wyatt-liao/yuhuan-x1/hardware/README.md

# 硬件

当前原生工程：[语环X1-独立麦克风与双按键.epro2](语环X1-独立麦克风与双按键.epro2)。使用嘉立创 EDA 专业版 / EasyEDA Pro 导入。

| 内容 | 入口 |
|---|---|
| 独立四麦与双按键改线 | [改线说明](reviews/语环X1-本次改线说明.md) |
| 改线后的 PCB 图 | [PCB 预览](reviews/语环X1-改线后PCB.png) |
| 初始板子的投产前审查 | [历史审查](reviews/PCB1-投产前审查.md) |
| 检查与改线证据压缩包 | [下载索引](../outputs/README.md#硬件与证据) |
| 对应固件与引脚 | [固件 README](../firmware/README.md) |
| 结构与电池槽 | [外壳 README](../enclosure/README.md) |

主控为 ESP32-S3-WROOM-1-N16R8。当前方案将四只麦克风的时钟、数据分开引出，双按键分别用于手动录音和暂停 / 回溯保存；具体 GPIO 以固件表格和原生工程为准。

电池方案为带保护板的 504060、3.7 V、2000 mAh，置于 PCB 槽内。外壳建模按电池引线直焊、移除直立 BAT1 XH 插座考虑，电池成品外形尚未实测；投板与装配前应核对原生工程和实际 BOM。

这里保留的是设计、修改和检查记录，尚无实板上电、录音或长时间验证结果。历史审查结论对应其记录时的板子状态，后续改线见对应说明。
