wyatt-liao/yuhuan-x1/media/README.md

# 产品影片与汇报

当前视频与汇报统一使用语环 X1 名称和 R03 CAD 结构：主体厚度 9.80 mm，含按键最高 10.15 mm，保留铝塑分区、外露圆头榫接和实际开孔。

- [R03 影片工程与播放说明](film/README.md)
- [当前 Blender 场景](film/assets/Yuhuan-X1-R03-CG.blend)
- [HTML 汇报与构建源码](report/README.md)
- [影片、汇报及源码包下载](../outputs/README.md)

手机画面来自当前 Android Demo；AI 整理与提醒仍为后续开发计划。结构、续航及硬件实物验证状态见[项目进度](../docs/PROJECT_STATUS.md)。旧概念片保留在历史下载中。
