wyatt-liao/yuhuan-x1/outputs/yuhuan-x1-report/使用说明.md

# 语环 X1 汇报使用说明

这套汇报共 14 页，建议讲述约 8 分钟。最后一页为参数附录。

## 放映

1. 用 Chrome、Edge 或 Safari 打开 `语环X1-产品研发汇报.html`。
2. 按 F 全屏，使用左右方向键或空格翻页。
3. 按 O 打开目录，按 N 查看当前页讲稿和资料来源，按 B 临时黑屏。

所有图片均内嵌，HTML 单独拷贝到其他电脑也可以离线放映。手机支持左右滑动；正式汇报推荐横屏或电脑投屏。HTML 需要在浏览器打开，聊天软件的文件预览可能不会执行交互脚本。

第 4 页可点击按钮，演示保存最近 1、3、6、24 小时的范围。这是机制演示，不连接实际录音卡。

讲稿弹窗会显示在当前屏幕，正式投屏前请关闭。可以把 `汇报讲稿.md` 放在手机上查看。PDF 备用版不含交互，适合发送资料或临时换电脑。

## 内容基准

当前视频、封面和汇报统一采用 R03 CAD 结构。主体厚度 9.80 mm，含按键最高 10.15 mm。24 小时是循环录音保留窗口；续航待实测。手机 AI 识别和提醒属于后续规划。

如需改文字，可直接编辑 HTML，或修改仓库 `media/report/` 下的构建源码。
