wyatt-liao/yuhuan-x1/hardware/reviews/语环X1-本次改线说明.md

# 语环 X1 本次改线说明

日期：2026-10-18。状态：原理图与 PCB 已现场修改，完成显式保存、关闭重载、逐脚回读、铜线连通检查及两轮原生 DRC。尚无实物上电测试。

已修改嘉立创窗口中 `MeetCard-AI-repair-loop-20261018 / Board1 / PCB1`。原生工程副本为 `语环X1-独立麦克风与双按键.epro2`。PCB 未制造，当前修改发生在工程内，无需实板飞线。

## 修改内容

第二按键 SW2.1 从 EN 改到 BTN2 / GPIO15 / U1.8；SW2.2 保持 GND，原有 EN 上拉、复位电容和 U1.3 的连接保留。SW1 保持 GPIO0。

四只麦克风保持共用 3V3 供电，每只拥有独立 CLOCK 和 DATA；没有增加负载开关、MOS 管或其他元件。

| 麦克风 | CLOCK | DATA | SELECT |
|---|---|---|---|
| MIC1 | GPIO4 / U1.4 / I2S_SCK | GPIO6 / U1.6 / I2S_DIN12 | GND |
| MIC2 | GPIO16 / U1.9 / CK2 | GPIO5 / U1.5 / D2 | 3V3 |
| MIC3 | GPIO17 / U1.10 / CK3 | GPIO7 / U1.7 / I2S_DIN34 | GND |
| MIC4 | GPIO18 / U1.11 / CK4 | GPIO8 / U1.12 / D4 | 3V3 |

旧网名 I2S_DIN12、I2S_DIN34 保留用于 MIC1、MIC3，名字不再代表两个麦克风共享。数据分别引出，避免停钟/启动时共享 DATA 的占用问题。GPIO5 原来的 I2S_WS 标签已移除；PDM 接口不用独立 WS。

## 钢网兼容范围

51 个器件的身份、坐标、朝向、所在面均未变；227 个焊盘实例的坐标和形状均未变；板框、丝印、禁布区和板内开槽/填充不变。两份原生工程内的 22 个 FOOTPRINT 文档体 SHA-256 完全相同，因此封装内焊膏开口、声孔及焊盘定义未变。这次改线本身不要求重做钢网。

没有取得你实际下单的钢网 Gerber/拼板定位文件，因此这里证明的是“相对改前工程保持兼容”。沿用下单时的拼板排列、工艺边和定位方式。

原生工程导出差异另含 Panel1 新增的 CANVAS 画布元数据（material=acrylic、thickness=0.8mm 等默认画布字段）；未调用面板编辑接口，此记录不是 PCB 叠层参数，也没有用作本次钢网或制板依据。P2/P4、全部库封装和其余设计文档体保持原样。实际制造请从 PCB1 导出并检查 Gerber，不要把 Panel1 当作钢网文件。

## 连接与规则复核

51 个器件、227 个焊盘实例与原理图逐脚网络对账一致。移除了归属明确的 41 段旧铜线、8 个过孔，新增 44 段线、10 个过孔；其他既有铜线保持。

保存重载后两轮原生 PCB DRC 均为 passed=true，total=0。下列新增网络用实际铜线逐一证明焊盘可达，包含真实换层和过孔，不以同名网代替物理连通。

| 网络 | 端点 | 实际中心线路径 | 过孔 |
|---|---|---:|---:|
| BTN2 | SW2.1 → U1.8 | 32.49mm | 2 |
| CK2 | U1.9 → MIC2.3 | 52.43mm | 2 |
| CK3 | U1.10 → MIC3.3 | 108.92mm | 0 |
| CK4 | U1.11 → MIC4.3 | 98.01mm | 2 |
| D2 | U1.5 → MIC2.1 | 52.95mm | 2 |
| D4 | U1.12 → MIC4.1 | 96.77mm | 2 |

路径不计过孔垂直长度，不是信号完整性仿真。新信号宽 6mil，沿原有电池/天线禁布区绕行。原理图保留基线已有的 BAT_ADC/GND 标签视觉重叠、C3 位号遮挡等图面警告；没有据此将电气连接判作通过或失败。

## 同步、校准与省电

采用同一个 I2S0 PDM RX 硬件时钟经 GPIO Matrix 分发，四只麦克风不是四套自由运行时钟。数据四路同时进入同一接收器。平时只让 MIC1 CLOCK 工作，其他 CLOCK 拉低；人声触发后连接同一时钟，MIC1 继续录制，固件约300ms后才使用新麦克风数据。

IM69D130 原厂资料的 Clock Off Mode 要求 CLOCK 拉低；表5给出启动/模式切换稳定时间：±0.5dB约20ms、±0.2dB约50ms。300ms是本 Demo 加上滤波/DMA余量的设计取值，仍需样机验证。原厂资料副本及读取文本存于证据包，来自库器件关联的 LCSC 数据手册页。

这种接法允许同步采集，分开走线本身不构成必须使用四套校准时钟的理由。但仍须实测：声道顺序、四路增益、固定相对延迟、反复停钟唤醒后的延迟是否一致，以及外壳声孔对声学响应的影响。PCB DRC 不验证这些事项。

当前固件做四麦声道选择，保存16kHz单声道 ADPCM WAV；没有声称已完成立体声输出、阵列校准、波束成形或 AI 降噪。手机 App 和 AI 提醒尚未实现，已交付本地 BLE/Wi-Fi 协议与手机后端模拟器。

2000mAh 电池续航仍需电池侧电流实测。停掉三只麦克风只降低相应麦克风/时钟负载，主控、SD、无线仍耗电，不能按四倍续航计算。

## 交付与未覆盖项

证据包含改线意图、原理图前后、PCB前后、删除/创建日志、保存与重载回执、两轮 DRC、六网路径、封装开口比对和最终工程导出记录。原始投产前审查保留为历史基线，电源/USB 的既有布局问题没有在本次麦克风和按键改线中处理。

可进入工程样机制作及功能调试。本次结果不构成量产放行；目前没有上电录音、USB枚举、SD压力、充放电和长期续航数据。烧录和手机同步的步骤见固件工程 README。
