wyatt-liao/yuhuan-x1/android/licenses/AndroidX-icons-NOTICE.md

# AndroidX Material icons

Selected outlined icon source files are copied without modification from Google AndroidX `material-icons-extended-android:1.7.8`, licensed under Apache-2.0. Original copyright headers remain in every file. The full extended binary library is not included.

Official Maven source artifact: `androidx/compose/material/material-icons-extended-android/1.7.8/material-icons-extended-android-1.7.8-sources.jar`

Source archive SHA-256: `77b7e782a519a3e074fc91e09d59334ac1b815edd87d2e89c0c9ca7c95678e93`

Vendored icons: AutoAwesome, BatteryStd, Bluetooth, BluetoothDisabled, BluetoothSearching, BookmarkBorder, BookmarkRemove, CalendarToday, ChevronRight, DeleteOutline, Download, EditNote, FiberManualRecord, Forward30, GraphicEq, History, LinkOff, MicNone, Pause, PhoneAndroid, PlayCircle, Replay10, SdCard, Sensors, Shield, Stop, Sync, Wifi

Other icons come from `material-icons-core`.

AutoMirrored outlined BluetoothSearching is also included from the same source archive.
