wyatt-liao/yuhuan-x1/outputs/yuhuan-x1-report/汇报讲稿.md

# 语环 X1 产品研发汇报讲稿

日期：2026-10-19。建议主体约 8 分钟，第 14 页为答疑参数。

## 01 语环 X1

大家好，今天汇报的是语环 X1，一款可以回溯保存的随身录音卡。我们希望解决一个很具体的问题：当用户意识到一句话很重要时，这句话往往已经说完了。语环先在设备上保留最近的录音，用户再通过一个简单的按键动作，把重要内容留下。当前硬件、固件、安卓端与结构文件已经形成配套工程，下一步进入实物验证。

资料：[项目总览](https://github.com/wyatt-liao/yuhuan-x1/blob/c01c0e15f273b57459ff1d528d4bf85e318d61fd/README.md)、[影片模型与结构的统一说明](https://github.com/wyatt-liao/yuhuan-x1/blob/main/media/film/README.md)

## 02 值得记录的时刻，常常先于录音动作

这页描述的是我们准备验证的使用场景，不是已经完成的市场调查。一个问题是录音启动晚于重要内容，另一个问题是录下之后很难再找。传统手动录音要求用户提前判断什么值得记录，而我们的设计把保存的决定放到事情发生之后。第一阶段先验证回溯保存是否真的方便，后续再用语音识别和信息整理降低重听成本。

## 03 设备负责记录，手机负责接收与整理

整体分工是，录音卡负责连续采集和本地保存，手机负责接收、播放和后续整理。当前 Demo 不建设云端服务，先利用手机作为本地后端。这样可以把设备采集、回溯保存和手机接收先联通，再接入真正的识别与 AI。这里展示的是 R03 的结构渲染，还不是已经完成实物装配的产品照片。

资料：[固件行为](https://github.com/wyatt-liao/yuhuan-x1/blob/c01c0e15f273b57459ff1d528d4bf85e318d61fd/firmware/README.md)、[Android 功能](https://github.com/wyatt-liao/yuhuan-x1/blob/c01c0e15f273b57459ff1d528d4bf85e318d61fd/android/README.md)

## 04 按一下，留下前一小时

这一页可以现场点击演示。默认单击一次，最后一小时会被标记保护。换成连续三次，就保护前三小时。设备不需要现场复制几小时的文件，而是保存持久化保护标记，避免这些内容被循环清理。回溯最多二十四小时，设备没录满时只能保留已有内容。需要特别区分：二十四小时描述的是录音保留窗口，电池续航还没有实测结果。

资料：[回溯保护与存储边界](https://github.com/wyatt-liao/yuhuan-x1/blob/c01c0e15f273b57459ff1d528d4bf85e318d61fd/firmware/README.md)、[按键与存储核心](https://github.com/wyatt-liao/yuhuan-x1/blob/c01c0e15f273b57459ff1d528d4bf85e318d61fd/firmware/components/yh_core/include/yh/buttons.hpp)

## 05 两个实体按键

实体交互保留两个按键。第一个按键负责一段手动录音的开始和结束。第二个按键在手动录音过程中用于暂停和继续，在没有手动录音时用于回溯保存。暂停时，后台环形录音仍然继续，所以不会因为用户暂停了一个手动任务，就失去整个回溯窗口。连续点击由固件统一判断，停止点击五百毫秒之后执行。

资料：[按键状态表](https://github.com/wyatt-liao/yuhuan-x1/blob/c01c0e15f273b57459ff1d528d4bf85e318d61fd/firmware/README.md)

## 06 硬件与手机的系统分工

硬件采用 ESP32-S3，四只麦克风独立引出时钟和数据，录音按一分钟分片存到 SD 卡。当前保存格式是十六千赫兹单声道 IMA ADPCM WAV，二十四小时音频大约七百零一兆字节。BLE 主要负责配对、控制和网络配置，大批量历史内容优先走同一局域网内的 Wi-Fi。手机在文件完整校验并落盘后才确认成功，真实吞吐和兼容性还需要实板联调。

资料：[硬件工程说明](https://github.com/wyatt-liao/yuhuan-x1/blob/c01c0e15f273b57459ff1d528d4bf85e318d61fd/hardware/README.md)、[设备同步协议](https://github.com/wyatt-liao/yuhuan-x1/blob/c01c0e15f273b57459ff1d528d4bf85e318d61fd/firmware/PROTOCOL.md)

## 07 按人声切换麦克风工作模式

功耗设计的重点是让采集资源随需求变化。平时只有第一只麦克风获得工作时钟，同时检测人声。确认有人声后，打开其他三路时钟，并留出稳定时间。当前算法进行声道选择和交叉淡化，输出仍然是单声道，没有把它包装成已实现的波束成形。四麦供电仍然共用，ESP32、SD 卡和无线也在耗电，因此不能用一麦来推算整机只消耗四分之一电量。

资料：[麦克风与功耗策略](https://github.com/wyatt-liao/yuhuan-x1/blob/c01c0e15f273b57459ff1d528d4bf85e318d61fd/firmware/README.md)、[采集实现](https://github.com/wyatt-liao/yuhuan-x1/blob/c01c0e15f273b57459ff1d528d4bf85e318d61fd/firmware/main/audio.cpp)

## 08 薄型结构的首件方案

轻薄是产品方向，影片、汇报和制造文件现在统一采用 R03 结构。首件为了适应树脂打印，主面与侧壁调整到两毫米，主体总厚度九点八毫米。电池放在 PCB 槽中，而不是叠在电路板上，连接改为引线直焊。结构保留外露圆头榫接以及未来铝塑分区，先完成样壳装配，再讨论 CNC 方案和进一步减薄。

资料：[R03 打印与装配](https://github.com/wyatt-liao/yuhuan-x1/blob/c01c0e15f273b57459ff1d528d4bf85e318d61fd/enclosure/r03/README-%E6%89%93%E5%8D%B0%E4%B8%8E%E6%8B%BC%E7%89%88%E8%AF%B4%E6%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)、[版本状态](https://github.com/wyatt-liao/yuhuan-x1/blob/c01c0e15f273b57459ff1d528d4bf85e318d61fd/docs/PROJECT_STATUS.md)

## 09 Android Demo 已形成可安装工程

安卓端已经形成可安装的原生 Demo，使用 Kotlin 和 Jetpack Compose。现在已经有设备连接、录音控制、文件接收、本地播放、备注和分享，也实现了断点续传与下载校验。画面是模拟器真实截图，里面的短音频来自测试 APK。当前软件不伪造转写或摘要，AI 页面会明确显示尚未分析。真实板子的配对、网络速度和后台稳定性还需要联调。

资料：[Android 实现与边界](https://github.com/wyatt-liao/yuhuan-x1/blob/c01c0e15f273b57459ff1d528d4bf85e318d61fd/android/README.md)、[Android 验证记录](https://github.com/wyatt-liao/yuhuan-x1/blob/c01c0e15f273b57459ff1d528d4bf85e318d61fd/android/release/verification.md)

## 10 下一阶段的 AI 生活助手

这是下一阶段的功能规划。设备把声音交给手机之后，我们希望手机先做转写，再从里面提取任务、时间和摘要。比如用户说周五下午三点发送方案，系统应识别出事项和候选时间，再让用户核对并确认提醒。它需要结合上下文处理日期和指代，所以不能只靠一个示例就宣称已经完成。目前 ASR、模型调用和提醒排程都还没有接入。

资料：[AI 当前状态](https://github.com/wyatt-liao/yuhuan-x1/blob/c01c0e15f273b57459ff1d528d4bf85e318d61fd/android/README.md)、[研发进度](https://github.com/wyatt-liao/yuhuan-x1/blob/c01c0e15f273b57459ff1d528d4bf85e318d61fd/docs/PROJECT_STATUS.md)

## 11 当前交付与验证进度

当前成果已经形成完整工程链：硬件有原生 PCB 和改线记录，固件有编译产物与主机测试，安卓有安装包、六项核心 JVM 测试和模拟器界面检查，结构有 STEP、STL 和几何报告。这里不使用一个笼统的完成百分比，而是把成果和下一项实物验证并排列出。最关键的缺口仍是第一块板子的上电和连续录音联调。

资料：[完整项目状态](https://github.com/wyatt-liao/yuhuan-x1/blob/c01c0e15f273b57459ff1d528d4bf85e318d61fd/docs/PROJECT_STATUS.md)、[Android 测试依据](https://github.com/wyatt-liao/yuhuan-x1/blob/c01c0e15f273b57459ff1d528d4bf85e318d61fd/android/release/verification.md)、[结构检查](https://github.com/wyatt-liao/yuhuan-x1/blob/c01c0e15f273b57459ff1d528d4bf85e318d61fd/enclosure/r03/verification/geometry-check.json)

## 12 下一步以样机验证推进

接下来的重点很明确。先把板子做出来，确认每一个麦克风与存储链路都工作，再验证连续录音和手机同步能同时运行。结构和电流需要真实测量，才能讨论进一步减薄和续航。完成这些之后，再接入手机侧 AI，并用真实录音检验转写与待办提取效果。阶段以验证结果推进，这里不虚构交付日期或预算。

资料：[实物验证清单](https://github.com/wyatt-liao/yuhuan-x1/blob/c01c0e15f273b57459ff1d528d4bf85e318d61fd/firmware/README.md)、[项目后续步骤](https://github.com/wyatt-liao/yuhuan-x1/blob/c01c0e15f273b57459ff1d528d4bf85e318d61fd/docs/PROJECT_STATUS.md)

## 13 重要的，回头还在

语环 X1 的核心是，把保存重要内容的决定，放到内容发生之后。当前已经完成配套工程与 Demo，近期的目标是让第一台样机完成连续录音、回溯保存和手机同步。项目资料已经公开，欢迎围绕硬件、结构和使用体验提出问题。谢谢。

资料：[公开仓库](https://github.com/wyatt-liao/yuhuan-x1/blob/c01c0e15f273b57459ff1d528d4bf85e318d61fd/README.md)

## 14 附录：参数与版本口径

这页用于答疑。涉及产品参数时以这里和工程 README 为准。影片和汇报现在统一使用九点八毫米主体的 R03 首件结构，最高处含按键为十点一五毫米。二十四小时是保留窗口，续航未实测。四路采集也不等于已经实现立体声、阵列算法或 AI。

资料：[固件参数](https://github.com/wyatt-liao/yuhuan-x1/blob/c01c0e15f273b57459ff1d528d4bf85e318d61fd/firmware/README.md)、[Android 参数](https://github.com/wyatt-liao/yuhuan-x1/blob/c01c0e15f273b57459ff1d528d4bf85e318d61fd/android/README.md)、[R03 参数](https://github.com/wyatt-liao/yuhuan-x1/blob/c01c0e15f273b57459ff1d528d4bf85e318d61fd/enclosure/r03/README-%E6%89%93%E5%8D%B0%E4%B8%8E%E6%8B%BC%E7%89%88%E8%AF%B4%E6%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)
