wyatt-liao/yuhuan-x1/android/design-reference/x1_3/screen.png

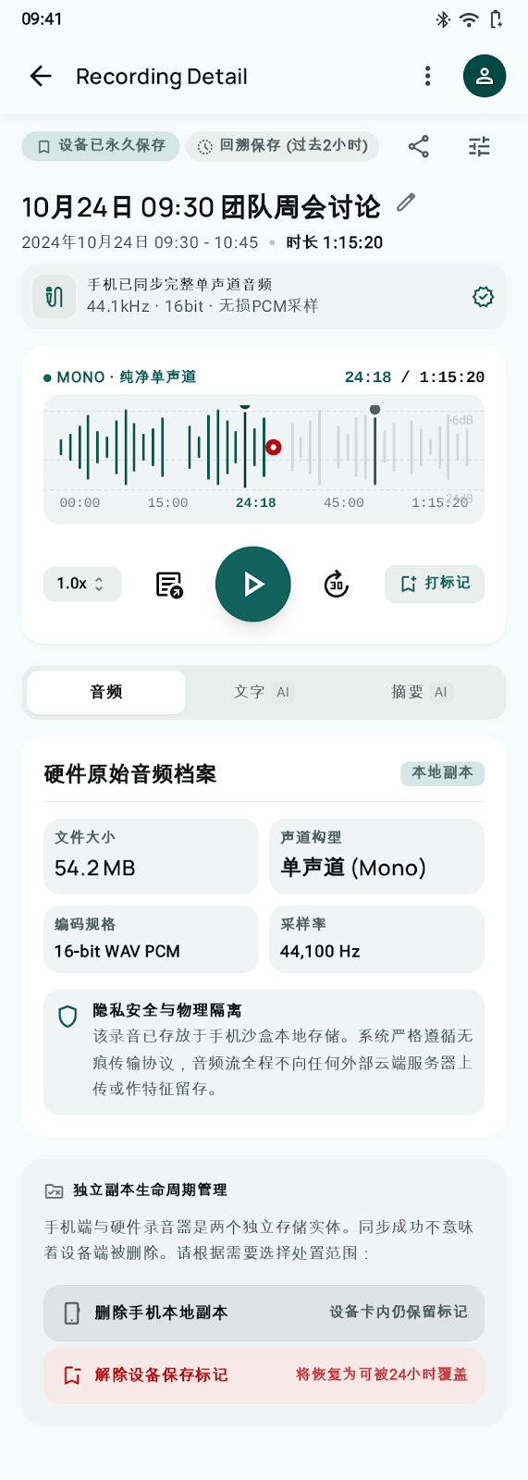
android/design-reference/x1_3/screen.png
