wyatt-liao/yuhuan-x1/android/design-reference/x1_4/screen.png

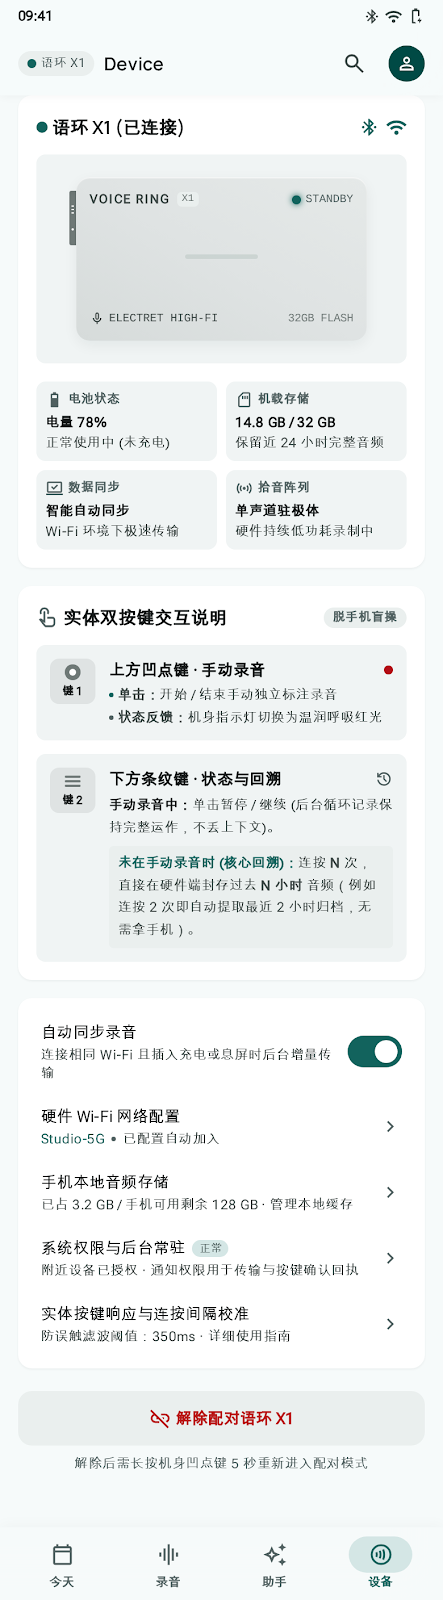
android/design-reference/x1_4/screen.png
