wyatt-liao/yuhuan-x1/android/release/preview.png

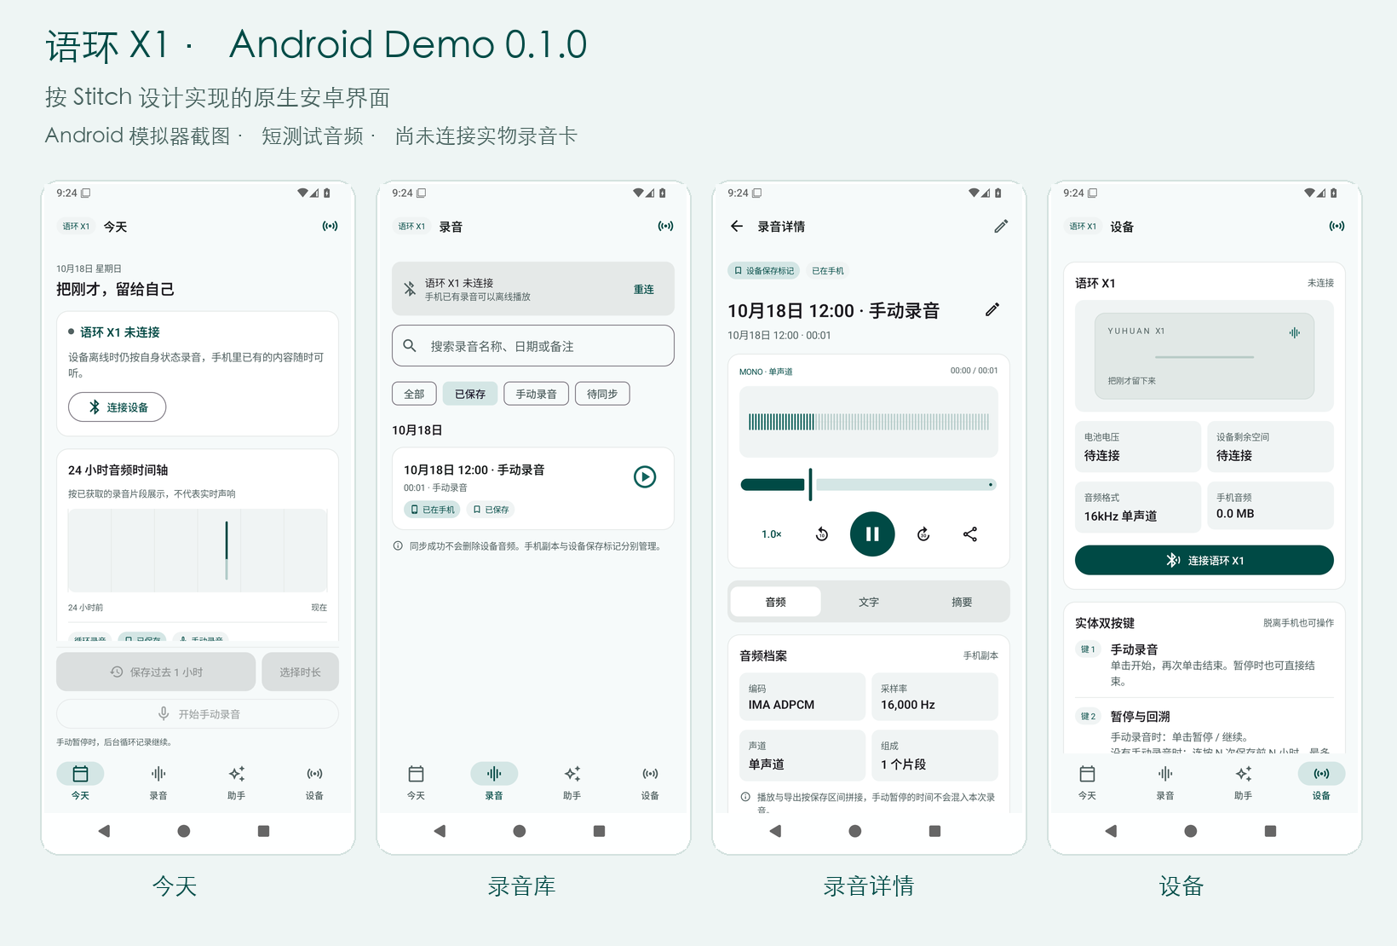
android/release/preview.png
