wyatt-liao/yuhuan-x1/android/release/screenshots/landscape/01-today.png

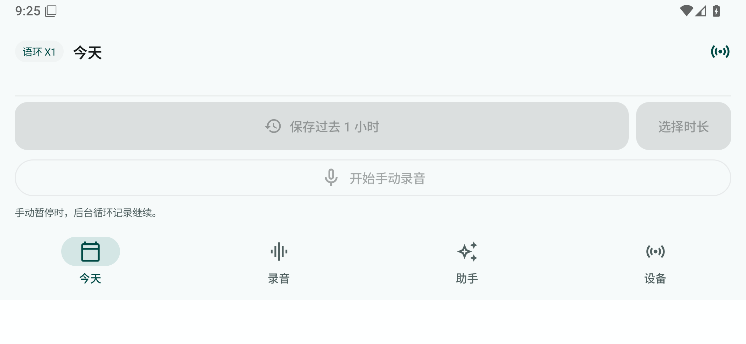
android/release/screenshots/landscape/01-today.png
