wyatt-liao/yuhuan-x1/android/release/screenshots/landscape/02-library.png

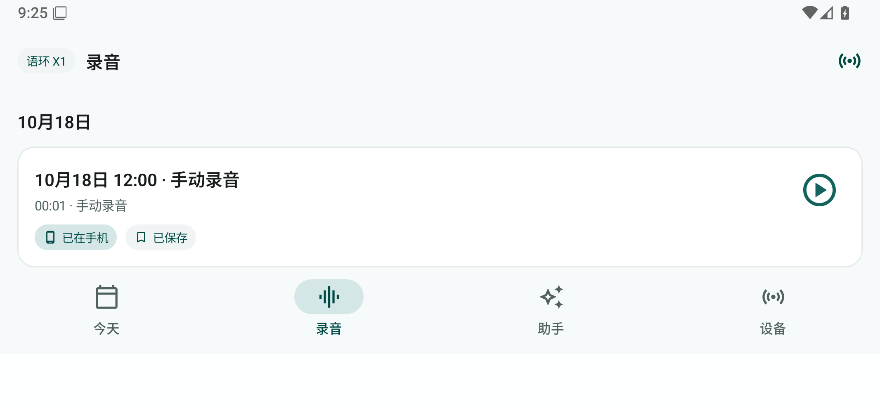
android/release/screenshots/landscape/02-library.png
