wyatt-liao/yuhuan-x1/android/release/screenshots/landscape/03-detail.png

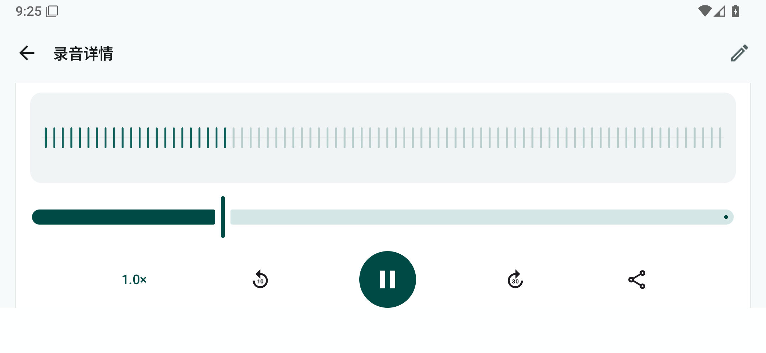
android/release/screenshots/landscape/03-detail.png
