wyatt-liao/yuhuan-x1/android/release/screenshots/landscape/04-assistant.png

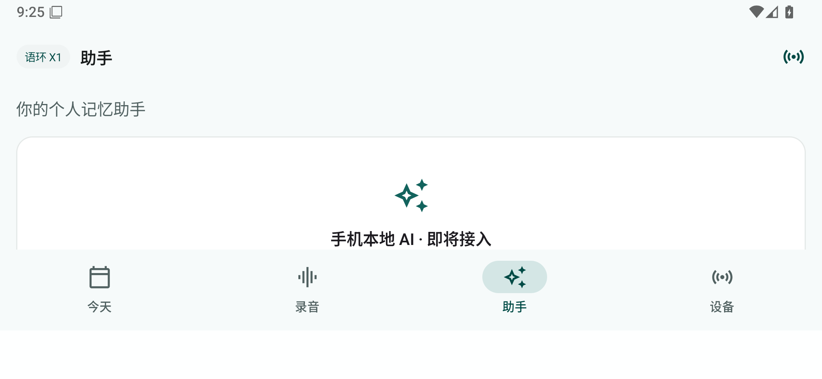
android/release/screenshots/landscape/04-assistant.png
