wyatt-liao/yuhuan-x1/android/release/screenshots/landscape/05-device.png

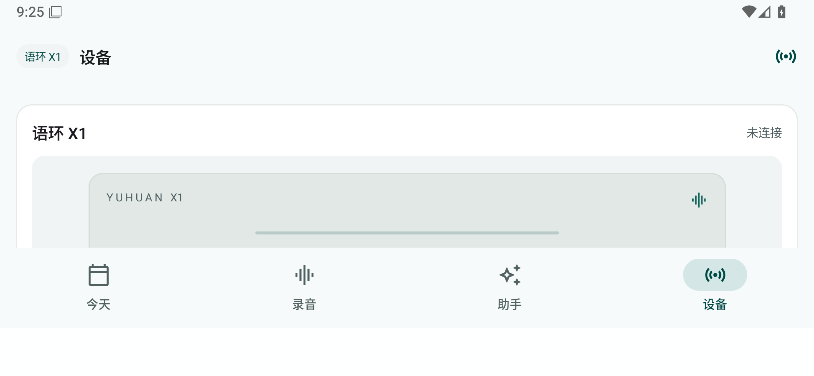
android/release/screenshots/landscape/05-device.png
