wyatt-liao/yuhuan-x1/android/release/screenshots/landscape/06-connect.png

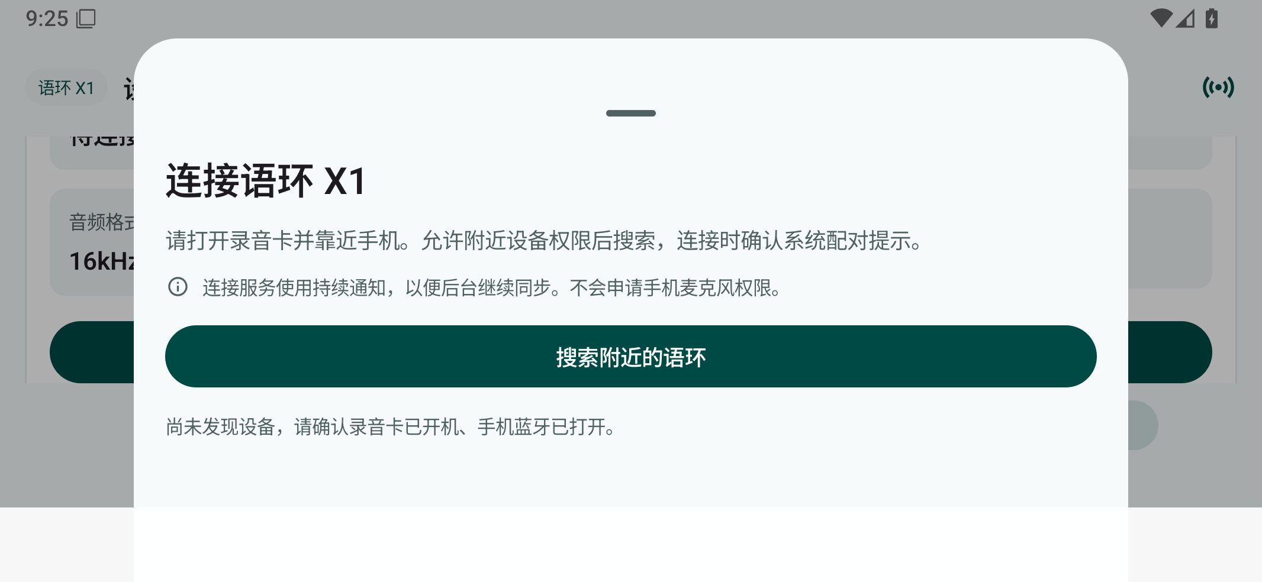
android/release/screenshots/landscape/06-connect.png
