wyatt-liao/yuhuan-x1/android/release/screenshots/normal/02-library.png

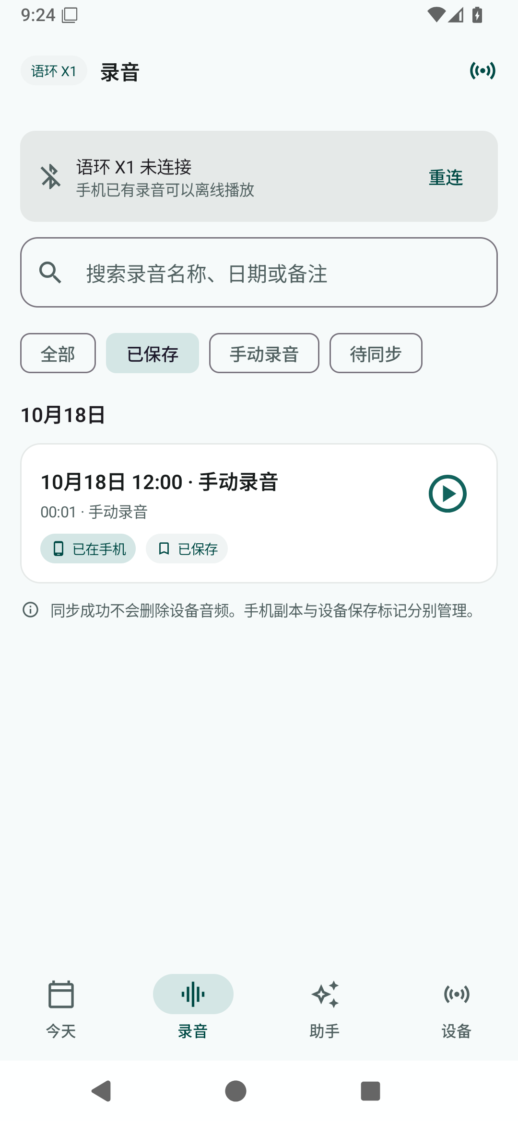
android/release/screenshots/normal/02-library.png
