wyatt-liao/yuhuan-x1/android/release/screenshots/normal/04-assistant.png

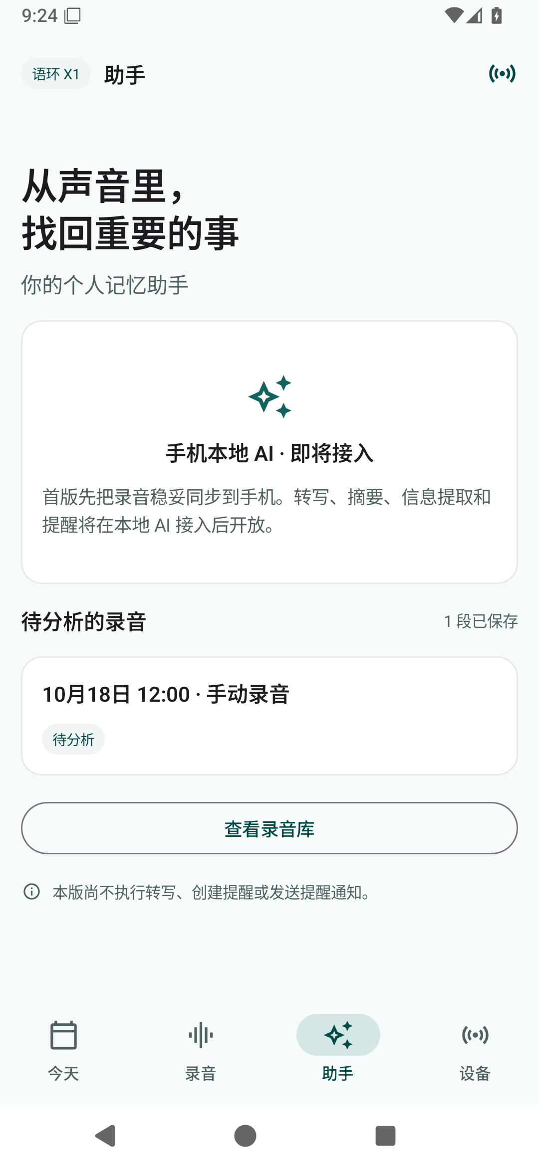
android/release/screenshots/normal/04-assistant.png
