wyatt-liao/yuhuan-x1/android/release/screenshots/normal/05-device.png

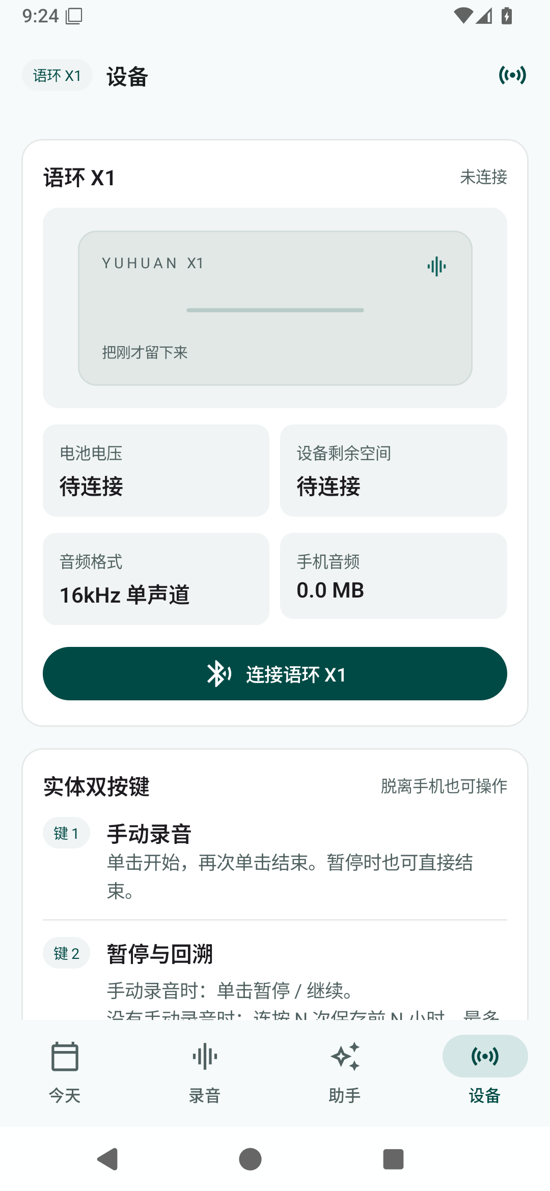
android/release/screenshots/normal/05-device.png
