wyatt-liao/yuhuan-x1/android/release/screenshots/normal/06-connect.png

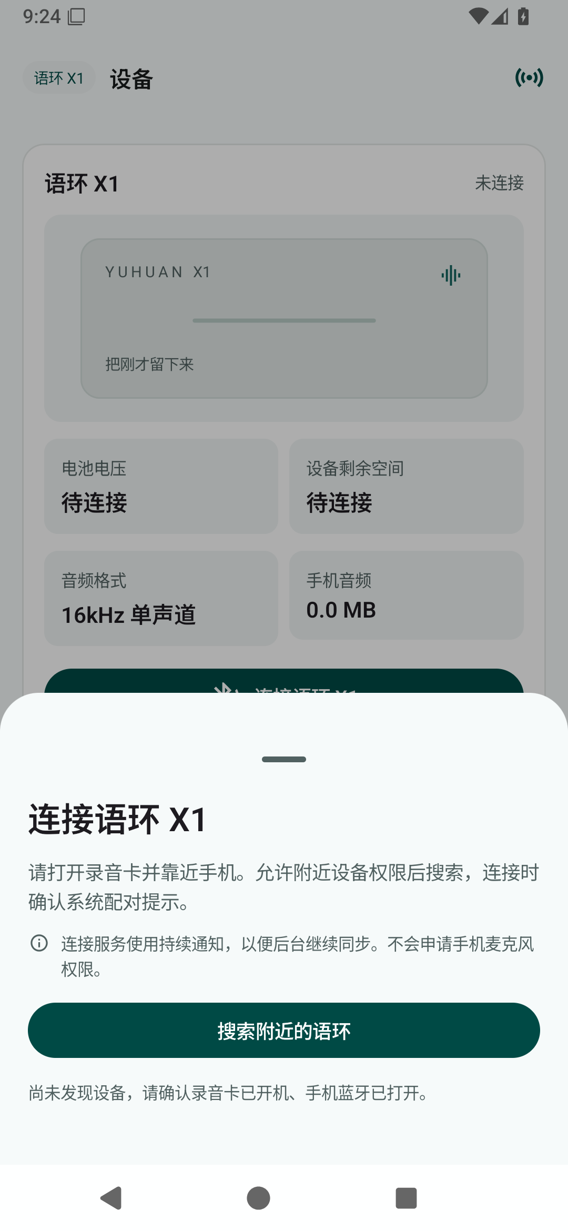
android/release/screenshots/normal/06-connect.png
