wyatt-liao/yuhuan-x1/android/release/screenshots/small-largefont/01-today.png

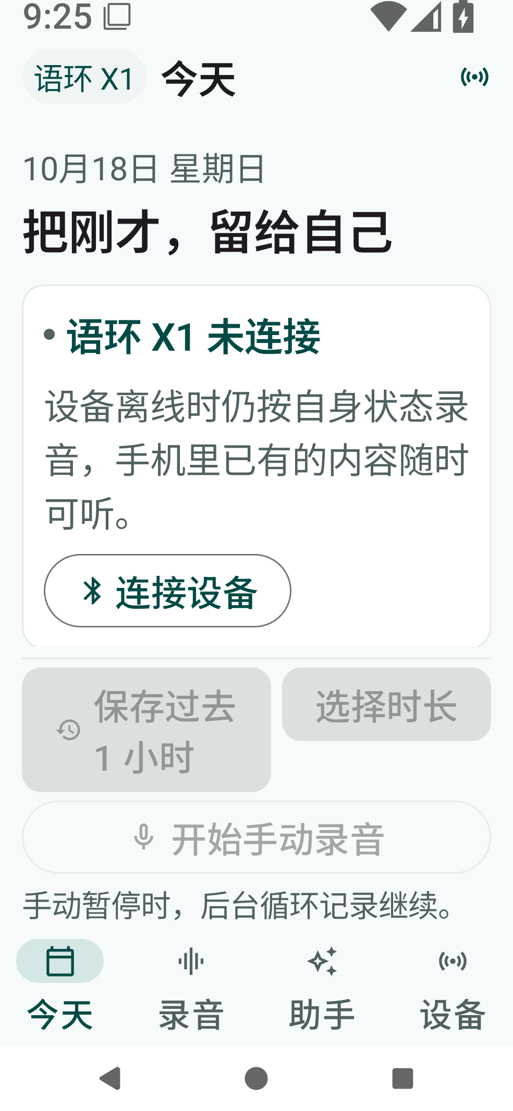
android/release/screenshots/small-largefont/01-today.png
