wyatt-liao/yuhuan-x1/android/release/screenshots/small-largefont/02-library.png

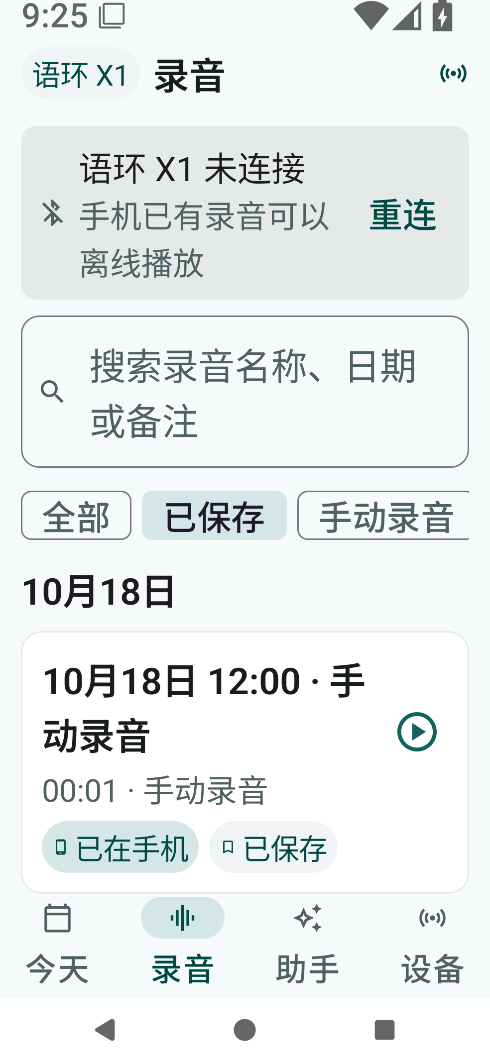
android/release/screenshots/small-largefont/02-library.png
