wyatt-liao/yuhuan-x1/android/release/screenshots/small-largefont/03-detail.png

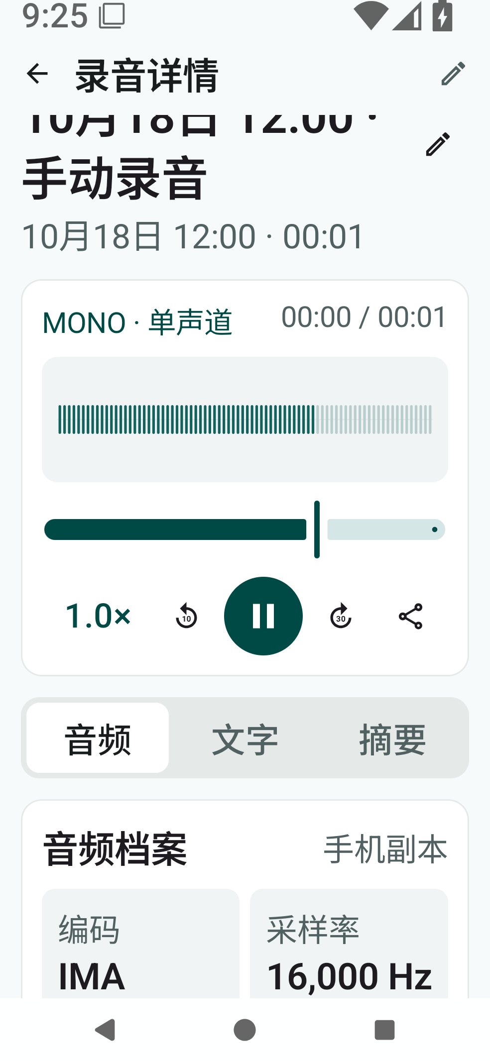
android/release/screenshots/small-largefont/03-detail.png
