wyatt-liao/yuhuan-x1/android/release/screenshots/small-largefont/04-assistant.png

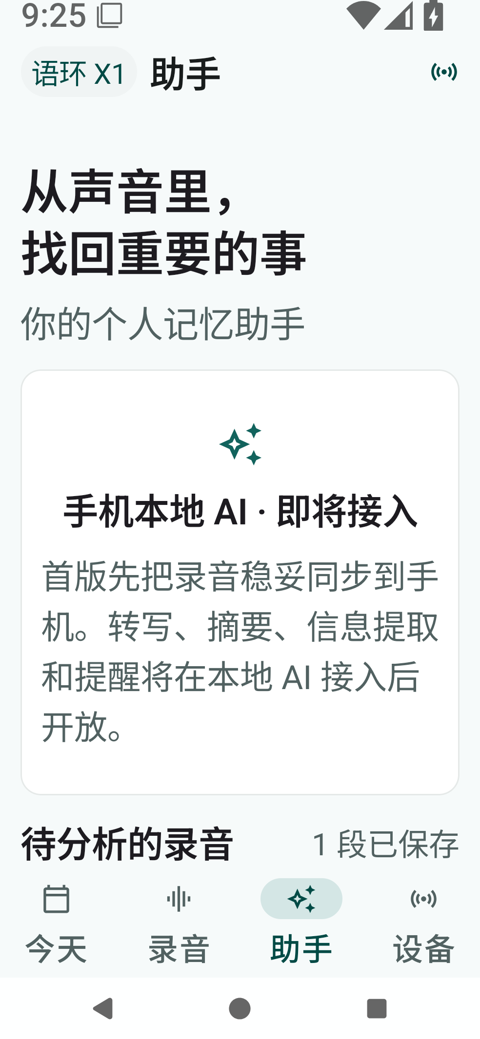
android/release/screenshots/small-largefont/04-assistant.png
