wyatt-liao/yuhuan-x1/android/release/screenshots/small-largefont/05-device.png

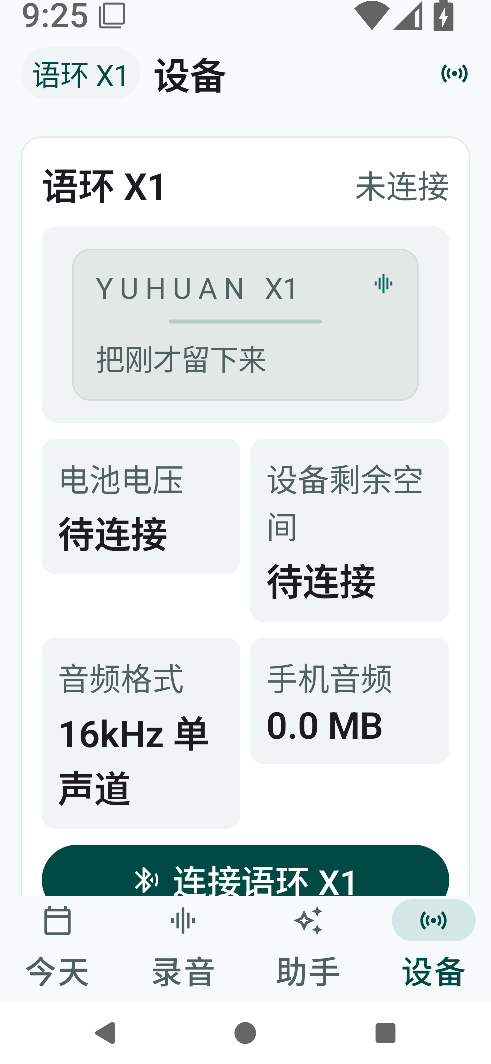
android/release/screenshots/small-largefont/05-device.png
