wyatt-liao/yuhuan-x1/android/release/screenshots/small-largefont/06-connect.png

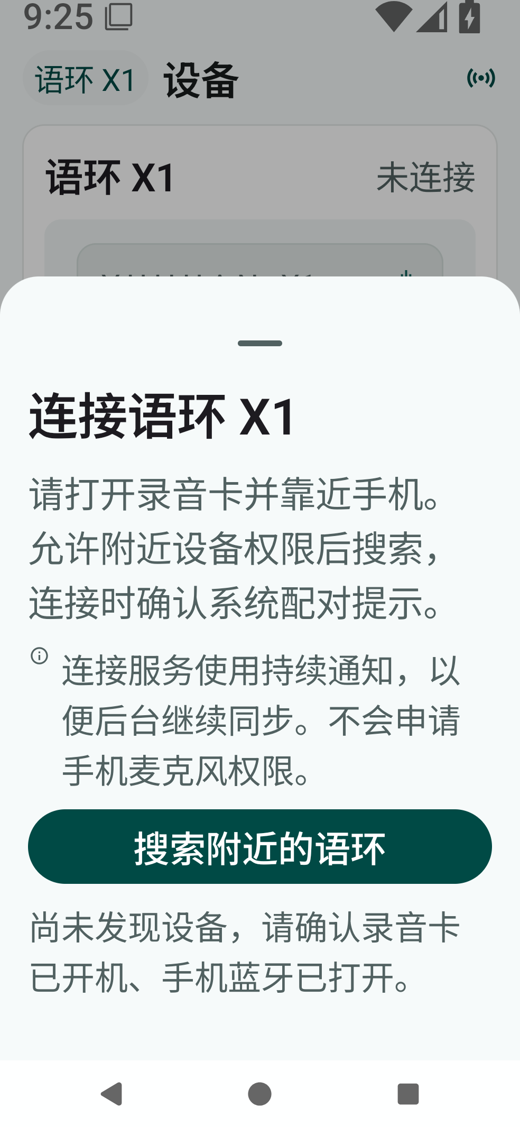
android/release/screenshots/small-largefont/06-connect.png
