wyatt-liao/yuhuan-x1/enclosure/r01/preview/01-front.png

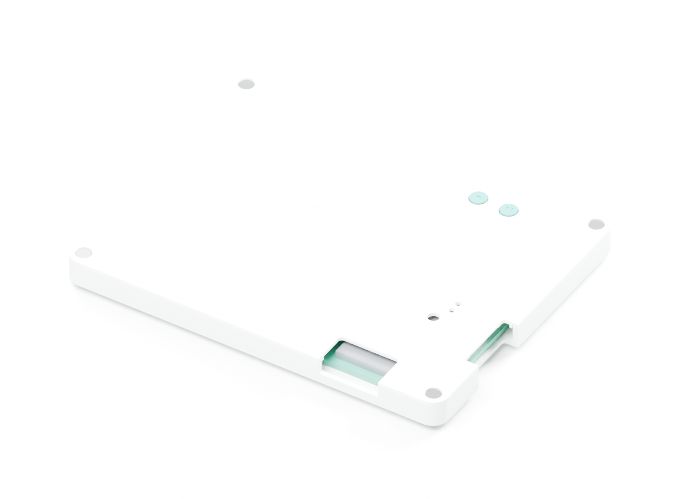
enclosure/r01/preview/01-front.png
