wyatt-liao/yuhuan-x1/enclosure/r01/preview/02-back.png

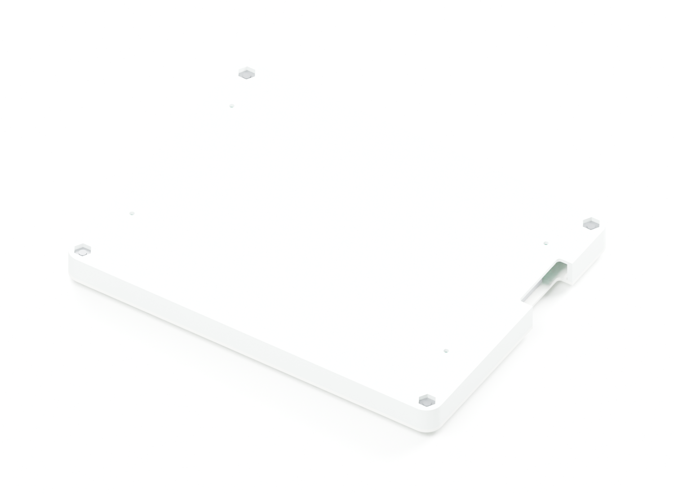
enclosure/r01/preview/02-back.png
