wyatt-liao/yuhuan-x1/enclosure/r01/preview/03-exploded.png

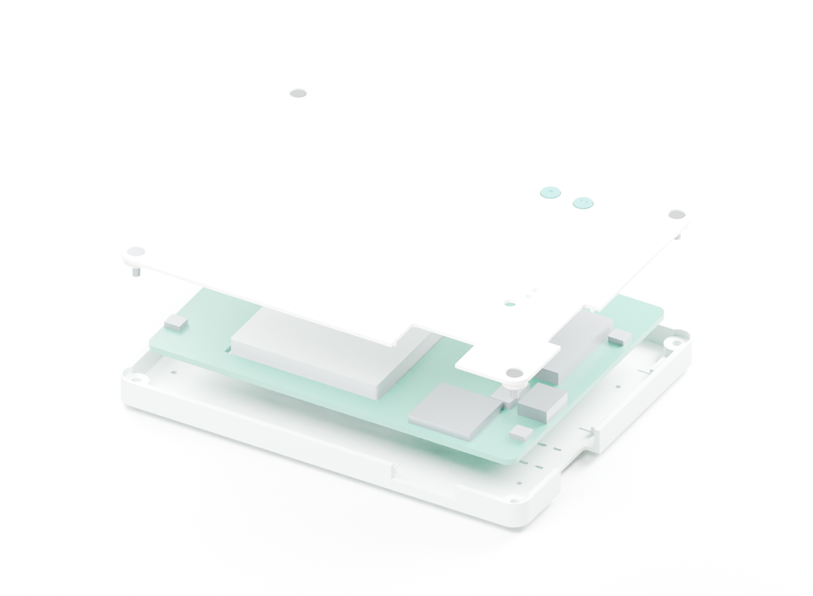
enclosure/r01/preview/03-exploded.png
