wyatt-liao/yuhuan-x1/enclosure/r01/preview/04-inside.png

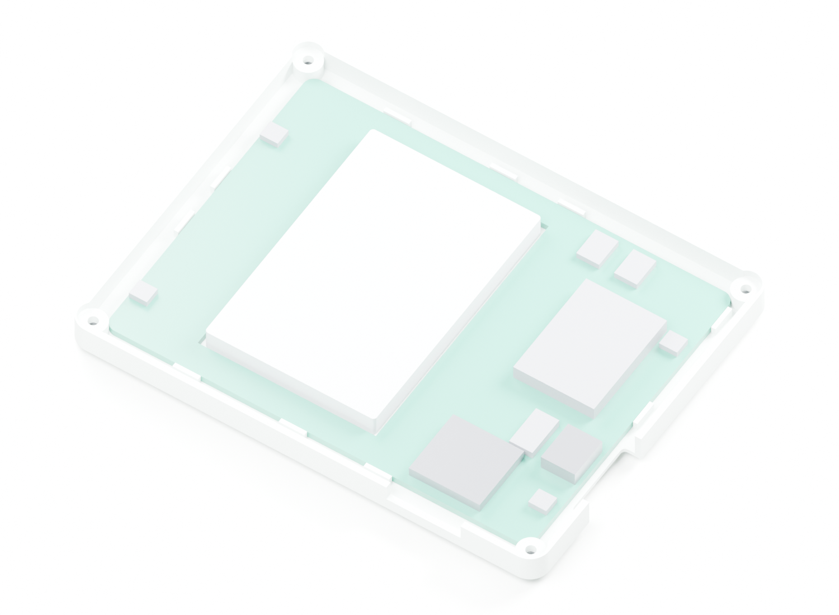
enclosure/r01/preview/04-inside.png
