wyatt-liao/yuhuan-x1/enclosure/r02/preview/00-overview.png

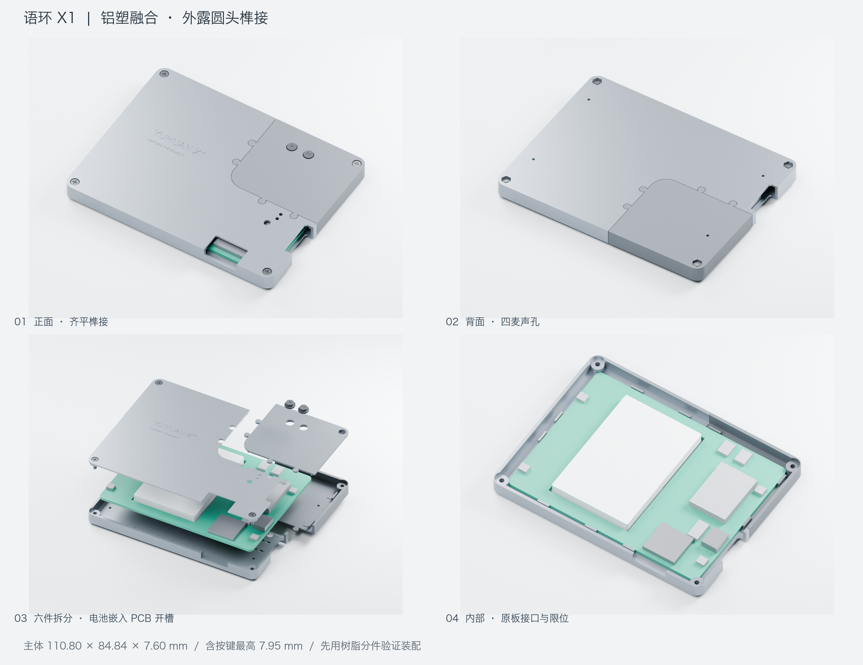
enclosure/r02/preview/00-overview.png
