wyatt-liao/yuhuan-x1/enclosure/r02/preview/01-front.png

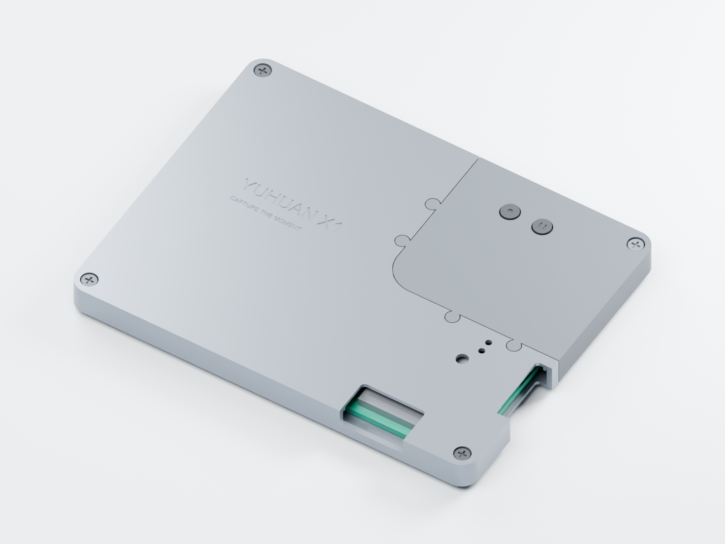
enclosure/r02/preview/01-front.png
