wyatt-liao/yuhuan-x1/enclosure/r02/preview/02-back.png

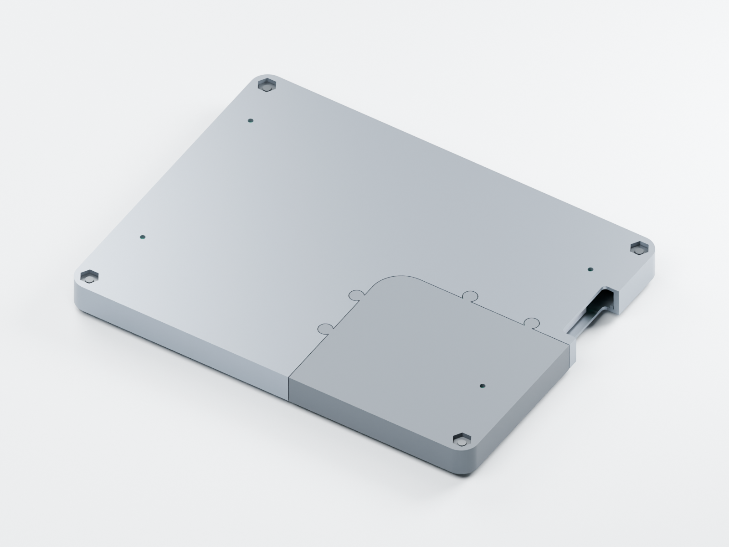
enclosure/r02/preview/02-back.png
