wyatt-liao/yuhuan-x1/enclosure/r02/preview/03-exploded.png

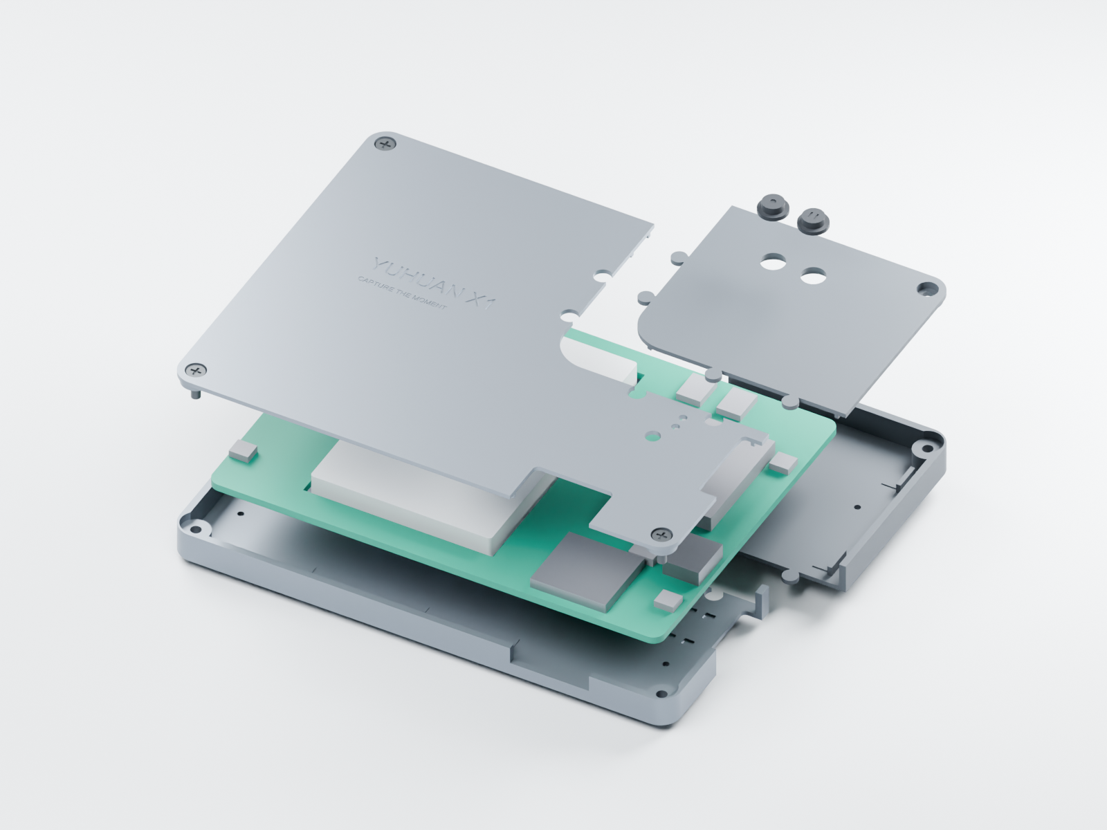
enclosure/r02/preview/03-exploded.png
