wyatt-liao/yuhuan-x1/enclosure/r02/preview/04-inside.png

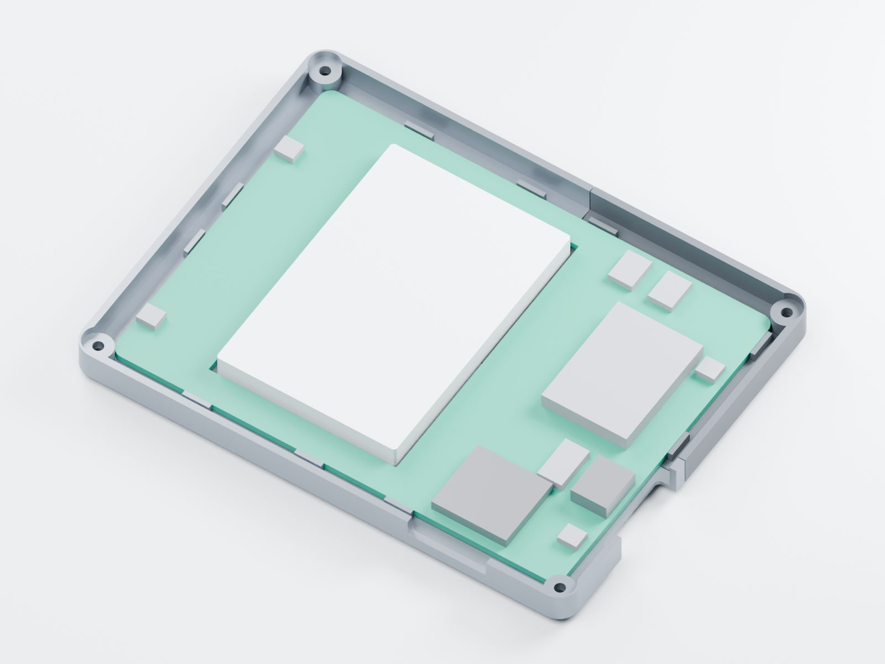
enclosure/r02/preview/04-inside.png
