wyatt-liao/yuhuan-x1/enclosure/r02/preview/05-joint-detail.png

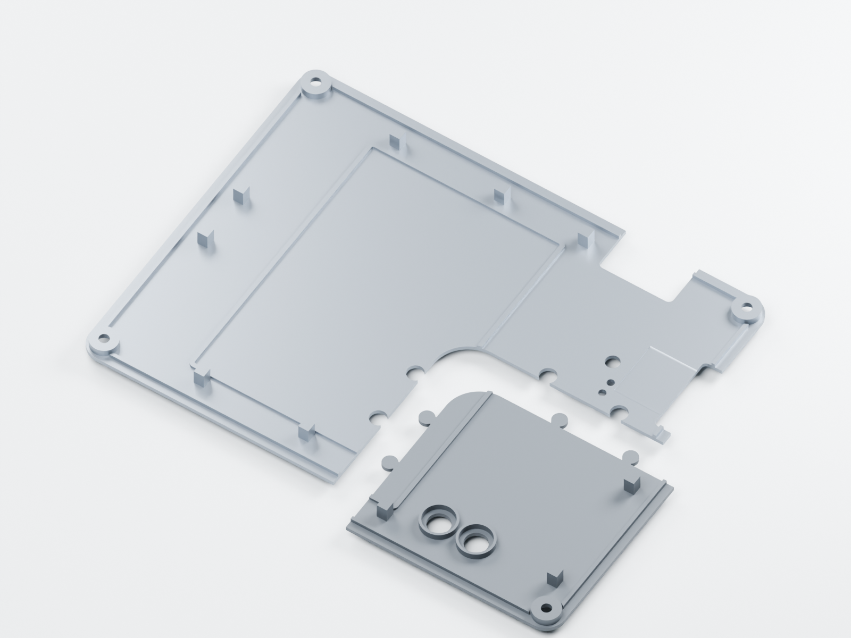
enclosure/r02/preview/05-joint-detail.png
