wyatt-liao/yuhuan-x1/enclosure/r02/preview/06-top.png

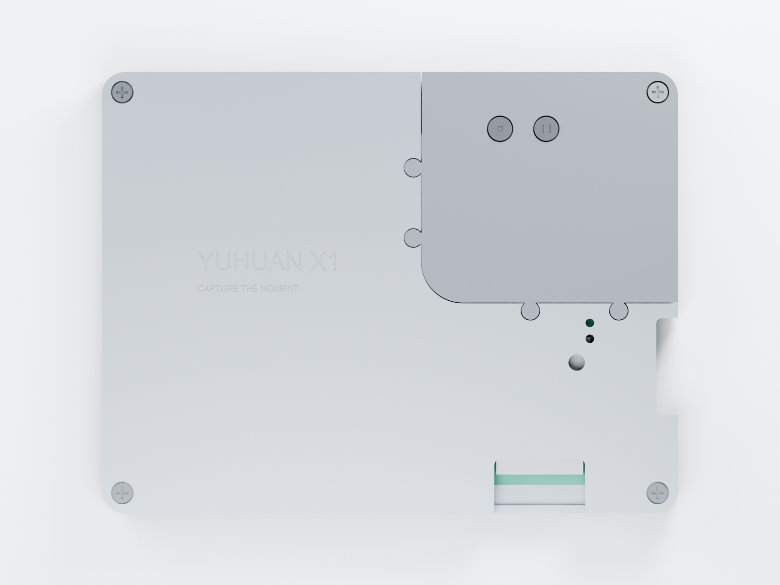
enclosure/r02/preview/06-top.png
