wyatt-liao/yuhuan-x1/enclosure/r02/preview/07-dimensions.png

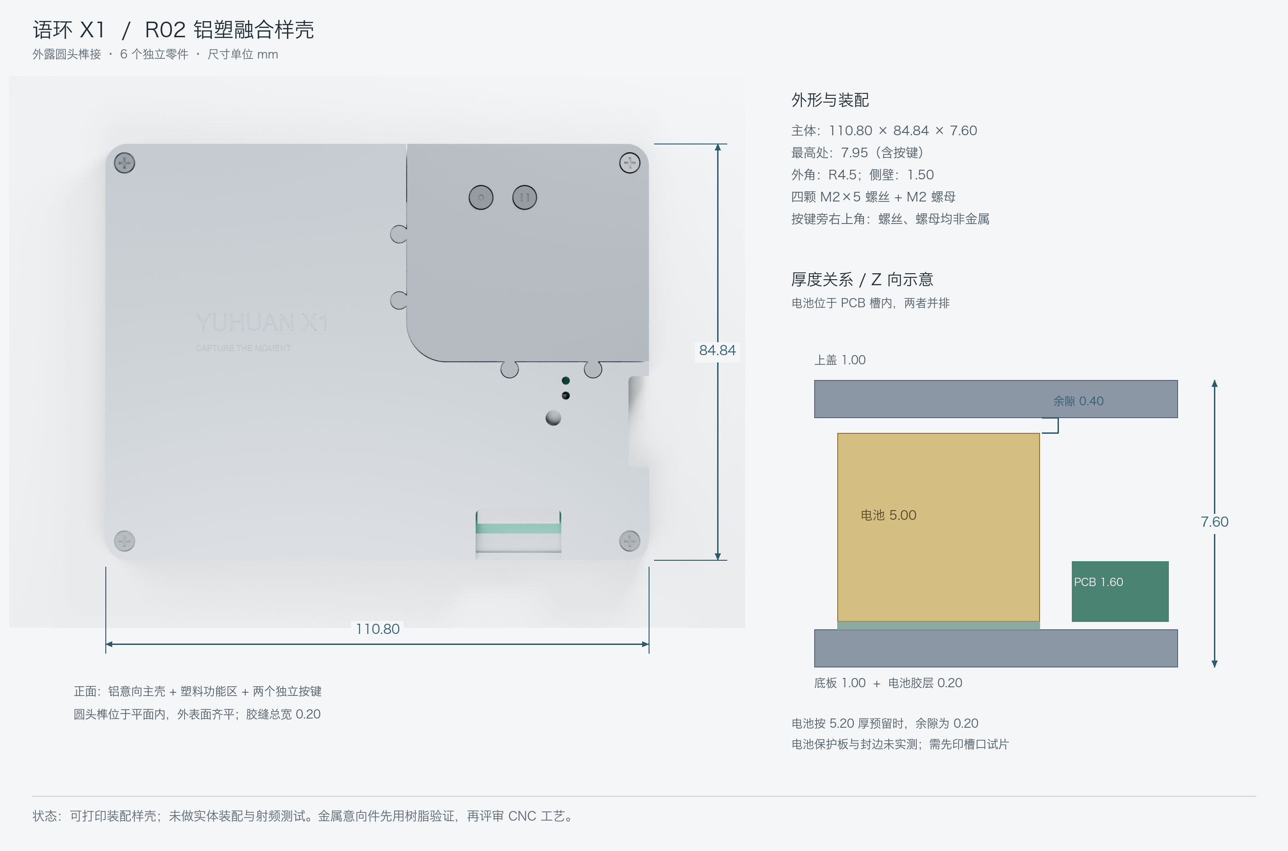
enclosure/r02/preview/07-dimensions.png
