wyatt-liao/yuhuan-x1/enclosure/r03/preview/06-top.png

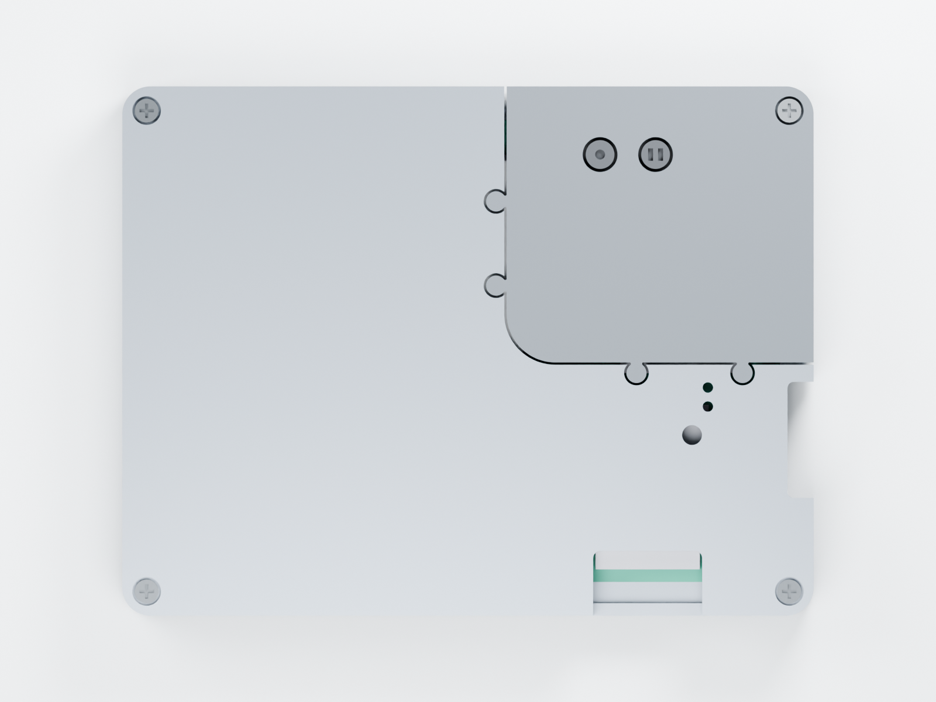
enclosure/r03/preview/06-top.png
