wyatt-liao/yuhuan-x1/enclosure/r03/preview/07-dimensions.png

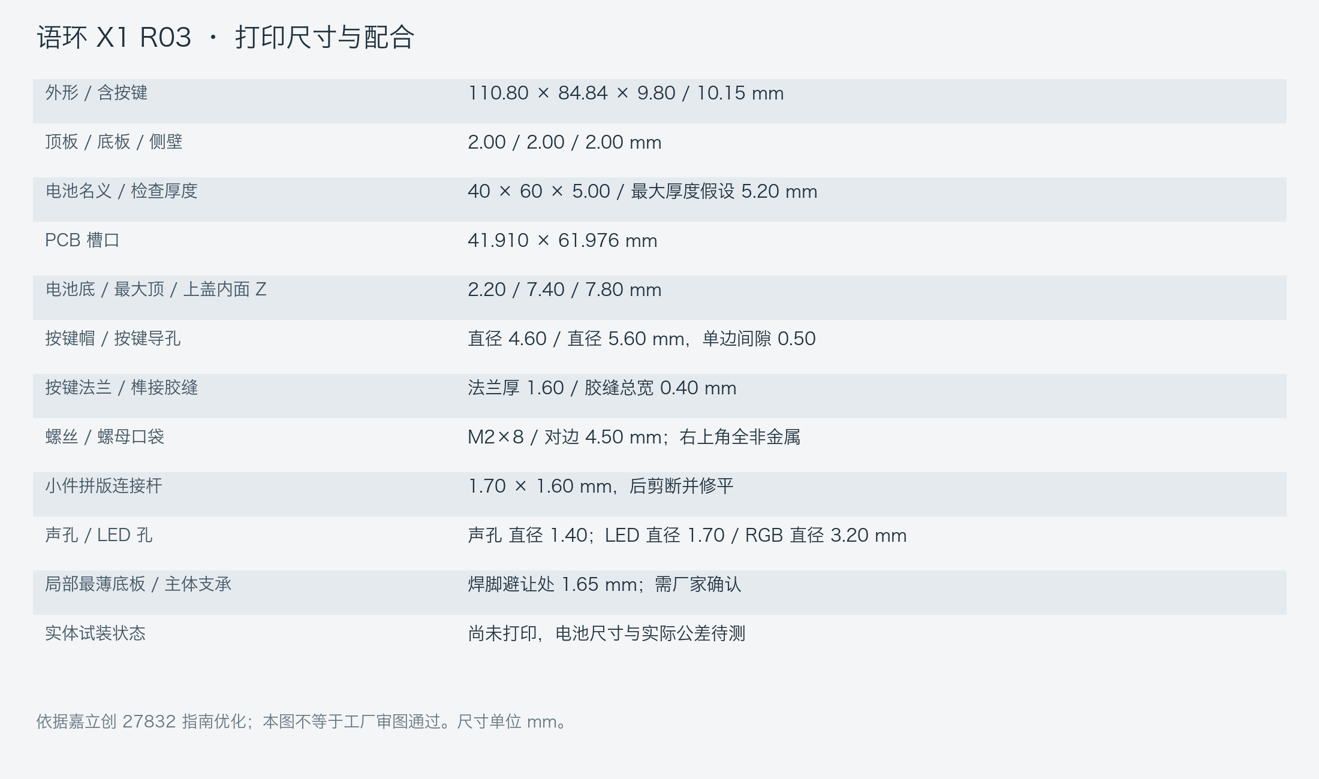
enclosure/r03/preview/07-dimensions.png
