wyatt-liao/yuhuan-x1/hardware/reviews/语环X1-改线后PCB.png

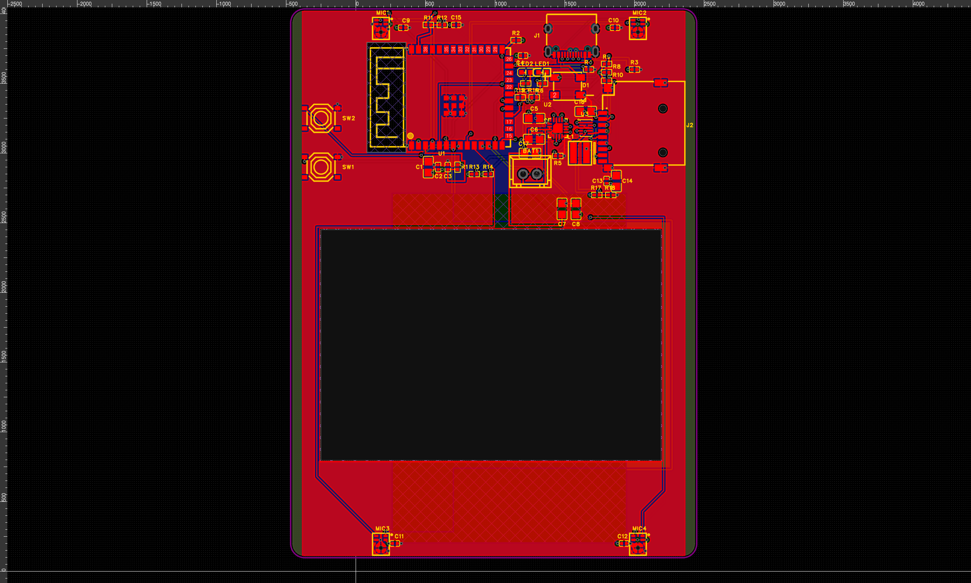
hardware/reviews/语环X1-改线后PCB.png
