wyatt-liao/yuhuan-x1/media/film/assets/android-detail.png

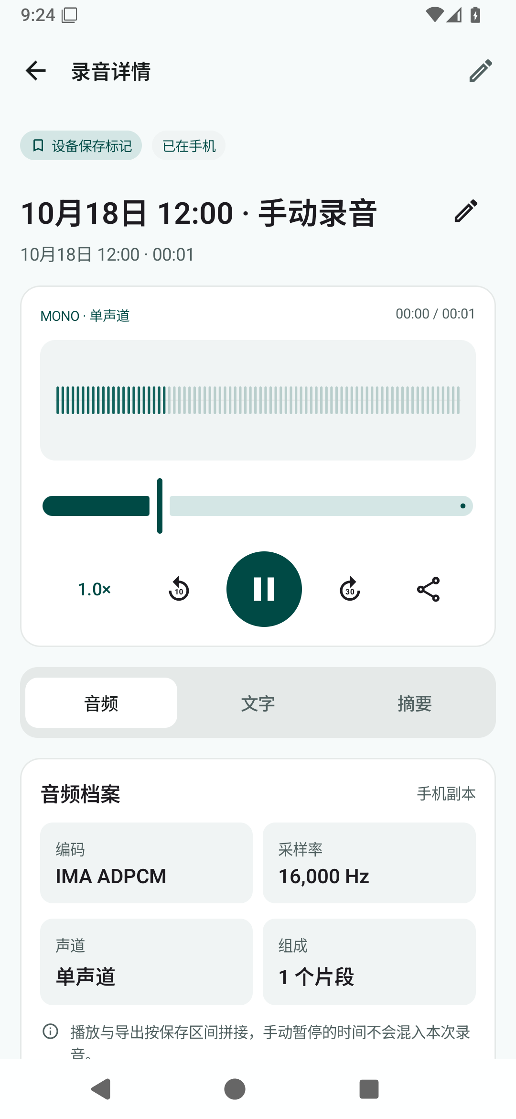
media/film/assets/android-detail.png
