wyatt-liao/yuhuan-x1/media/film/assets/android-today.png

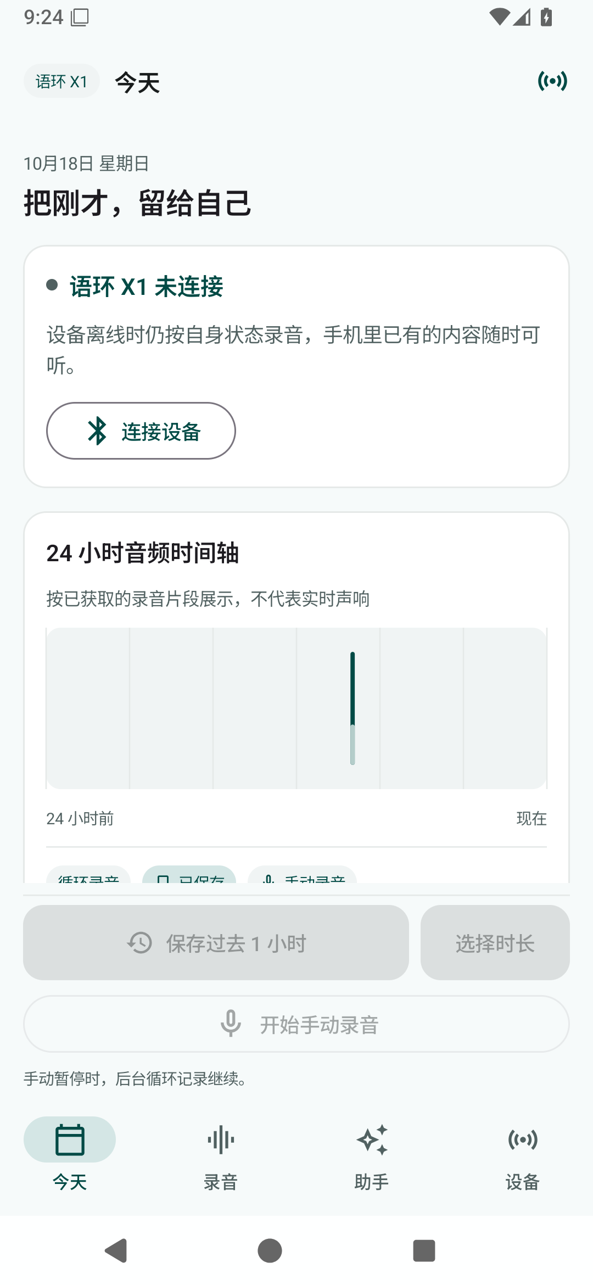
media/film/assets/android-today.png
