wyatt-liao/yuhuan-x1/media/film/assets/r03-hero.jpg

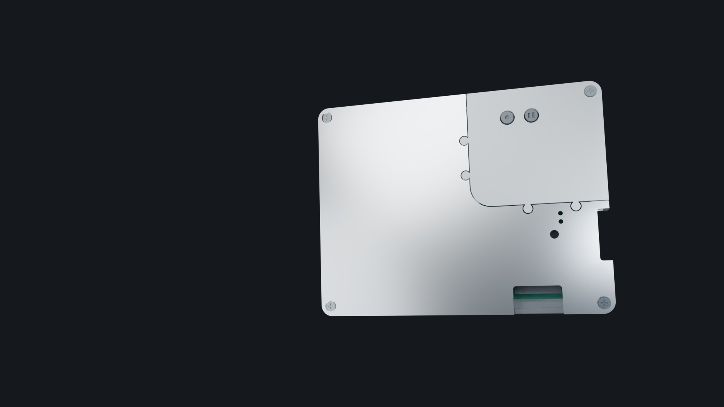
media/film/assets/r03-hero.jpg
