wyatt-liao/yuhuan-x1/outputs/Voloop-X1-CG播放器预览.png

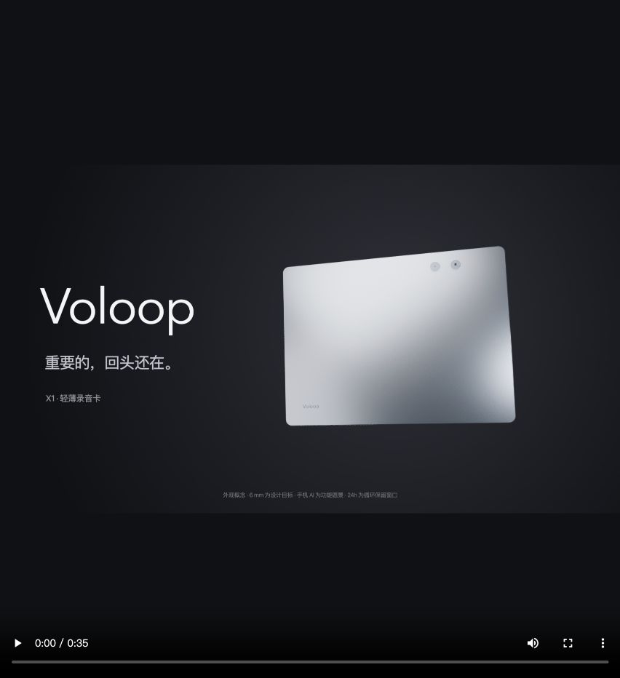
outputs/Voloop-X1-CG播放器预览.png
