wyatt-liao/yuhuan-x1/outputs/Voloop-X1-Cycles渲染预览.jpg

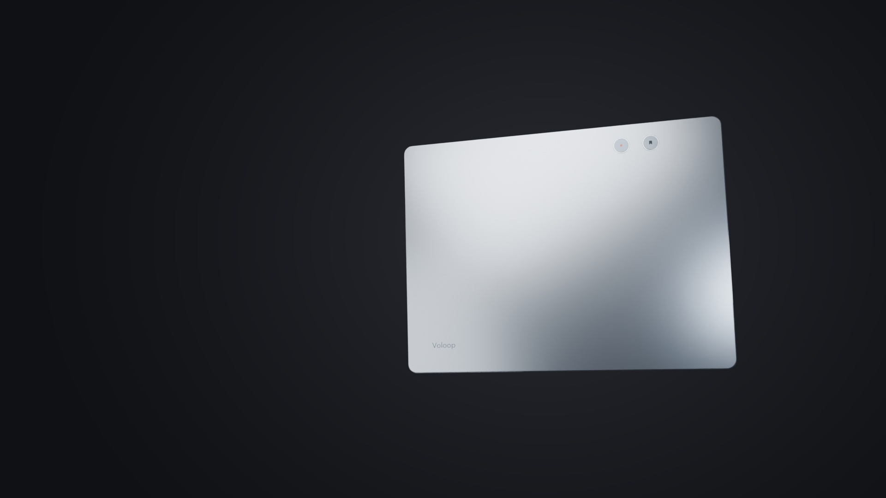
outputs/Voloop-X1-Cycles渲染预览.jpg
