wyatt-liao/yuhuan-x1/outputs/Voloop-X1-运镜修正预览.png

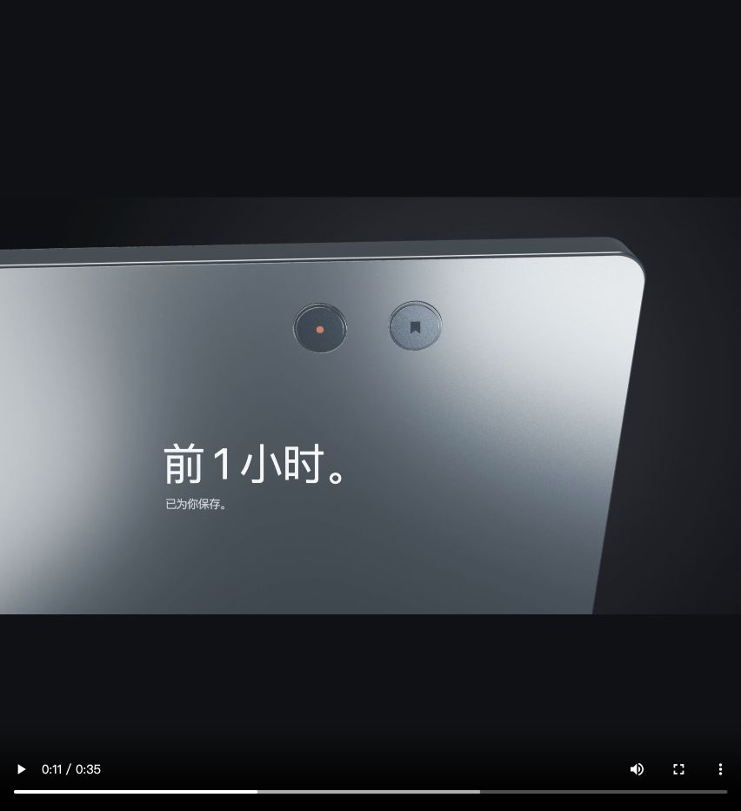
outputs/Voloop-X1-运镜修正预览.png
