wyatt-liao/yuhuan-x1/outputs/yuhuan-x1-report/封面预览.jpg

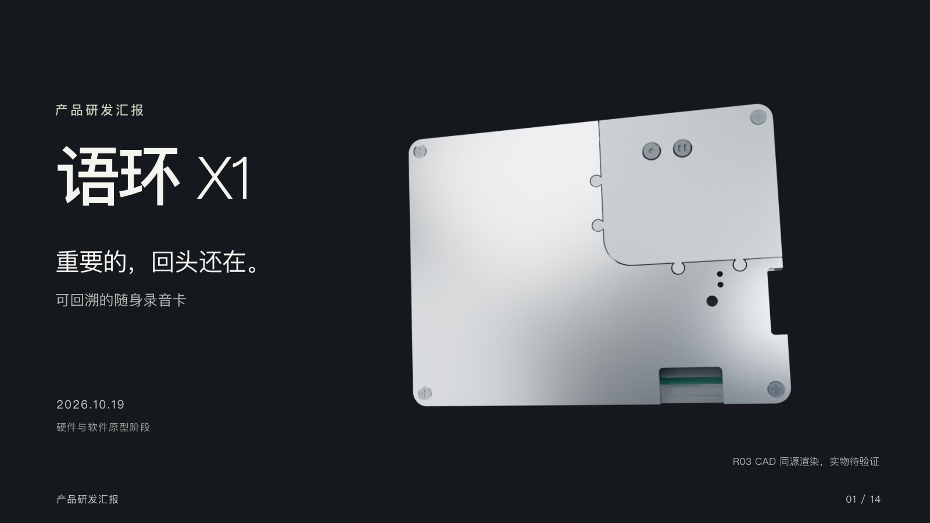
outputs/yuhuan-x1-report/封面预览.jpg
