wyatt-liao/yuhuan-x1/outputs/语环X1-影片封面.png

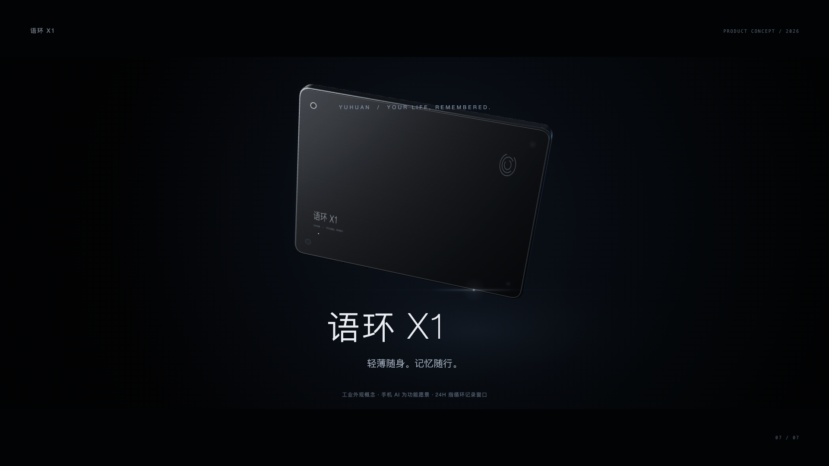
outputs/语环X1-影片封面.png
