wyatt-liao/yuhuan-x1/enclosure/r03/step/x1_assembly_reference.step

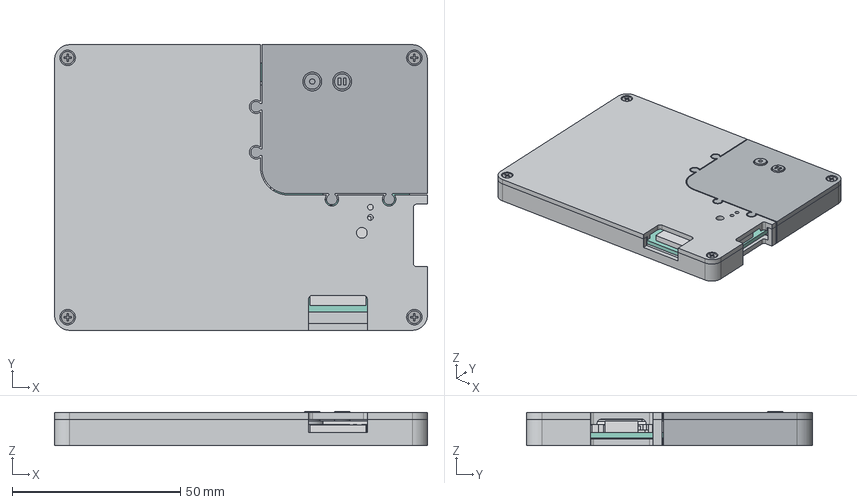
[picture p50: CAD file, 2026-10-19]
enclosure/r03/step/x1_assembly_reference.step
110.8 x 84.8 x 10.2 mm
base_metal_part
base_rf_plastic_part
lid_metal_part
lid_rf_plastic_part
button_record_part
button_recall_part
PCB_WITH_BATTERY_CUTOUT_reference_part
BATTERY_NOMINAL_ONLY_NOT_MEASURED_part
SW1_HEIGHT_ENVELOPE_part
C2_HEIGHT_ENVELOPE_part
SW2_HEIGHT_ENVELOPE_part
C3_HEIGHT_ENVELOPE_part
C4_HEIGHT_ENVELOPE_part
C5_HEIGHT_ENVELOPE_part
C6_HEIGHT_ENVELOPE_part
C7_HEIGHT_ENVELOPE_part
J1_HEIGHT_ENVELOPE_part
LED1_HEIGHT_ENVELOPE_part
LED2_HEIGHT_ENVELOPE_part
R1_HEIGHT_ENVELOPE_part
C1_HEIGHT_ENVELOPE_part
R2_HEIGHT_ENVELOPE_part
R3_HEIGHT_ENVELOPE_part
R4_HEIGHT_ENVELOPE_part
R5_HEIGHT_ENVELOPE_part
R6_HEIGHT_ENVELOPE_part
R7_HEIGHT_ENVELOPE_part
C13_HEIGHT_ENVELOPE_part
C14_HEIGHT_ENVELOPE_part
J2_HEIGHT_ENVELOPE_part
R8_HEIGHT_ENVELOPE_part
R9_HEIGHT_ENVELOPE_part
R10_HEIGHT_ENVELOPE_part
C9_HEIGHT_ENVELOPE_part
C10_HEIGHT_ENVELOPE_part
C11_HEIGHT_ENVELOPE_part
C12_HEIGHT_ENVELOPE_part
MIC1_HEIGHT_ENVELOPE_part
MIC2_HEIGHT_ENVELOPE_part
MIC3_HEIGHT_ENVELOPE_part
MIC4_HEIGHT_ENVELOPE_part
C15_HEIGHT_ENVELOPE_part
R11_HEIGHT_ENVELOPE_part
R12_HEIGHT_ENVELOPE_part
R13_HEIGHT_ENVELOPE_part
R14_HEIGHT_ENVELOPE_part
C8_HEIGHT_ENVELOPE_part
C16_HEIGHT_ENVELOPE_part
C17_HEIGHT_ENVELOPE_part
D1_HEIGHT_ENVELOPE_part
L1_HEIGHT_ENVELOPE_part
R15_HEIGHT_ENVELOPE_part
R16_HEIGHT_ENVELOPE_part
R17_HEIGHT_ENVELOPE_part
R18_HEIGHT_ENVELOPE_part
U1_HEIGHT_ENVELOPE_part
U2_HEIGHT_ENVELOPE_part
U3_HEIGHT_ENVELOPE_part
M2x8_unthreaded_reference_0_metal_part
M2_nut_unthreaded_reference_0_metal_part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
