wyatt-liao/yuhuan-x1/enclosure/r01/reference/pcb_with_cutout.step

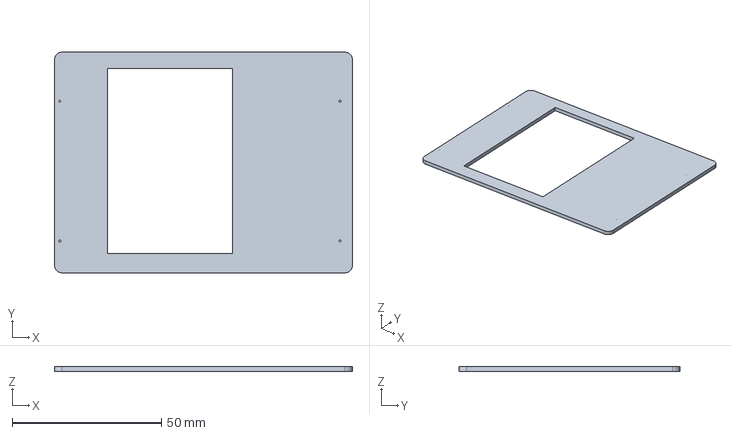
[picture p51: CAD file, 2026-10-19]
enclosure/r01/reference/pcb_with_cutout.step
100.0 x 74.0 x 1.60 mm
