wyatt-liao/yuhuan-x1/enclosure/r01/step/x1_button_record.step

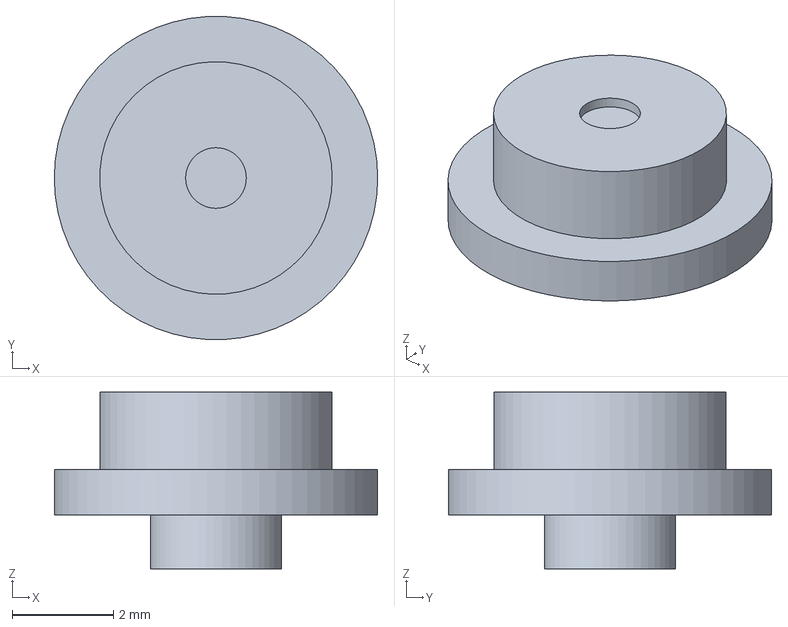
[picture p52: CAD file, 2026-10-19]
enclosure/r01/step/x1_button_record.step
6.40 x 6.39 x 3.50 mm
