wyatt-liao/yuhuan-x1/enclosure/r02/step/x1_lid_metal.step

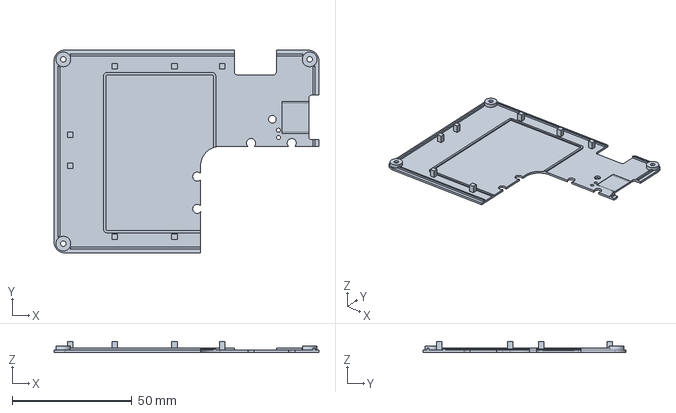
[picture p54: CAD file, 2026-10-19]
enclosure/r02/step/x1_lid_metal.step
110.8 x 84.8 x 4.70 mm
