wyatt-liao/yuhuan-x1/enclosure/r02/stl/x1_fit_coupon.stl

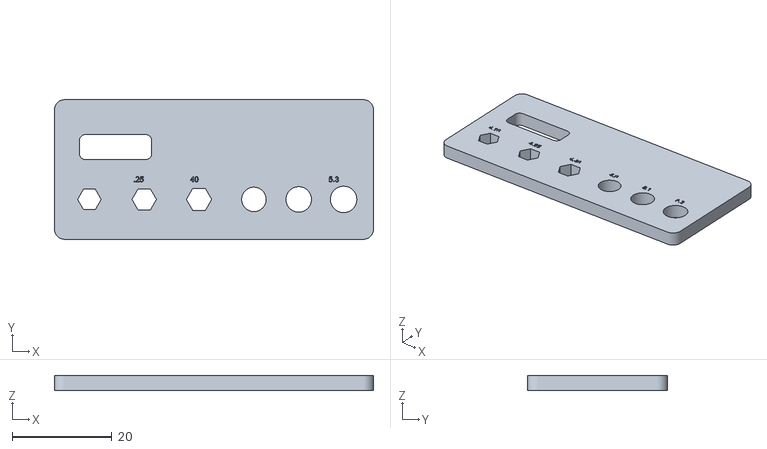
[picture p55: CAD file, 2026-10-19]
enclosure/r02/stl/x1_fit_coupon.stl
64.0 x 28.0 x 3.00
