wyatt-liao/yuhuan-x1/enclosure/r03/step/x1_lid_rf_plastic.step

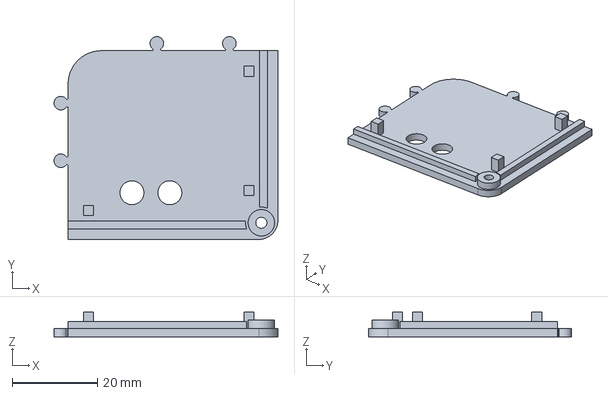
[picture p56: CAD file, 2026-10-19]
enclosure/r03/step/x1_lid_rf_plastic.step
52.5 x 47.5 x 5.85 mm
