wyatt-liao/yuhuan-x1/enclosure/r03/step_optional/x1_buttons_on_sprue_CUT_AFTER_PRINT.step

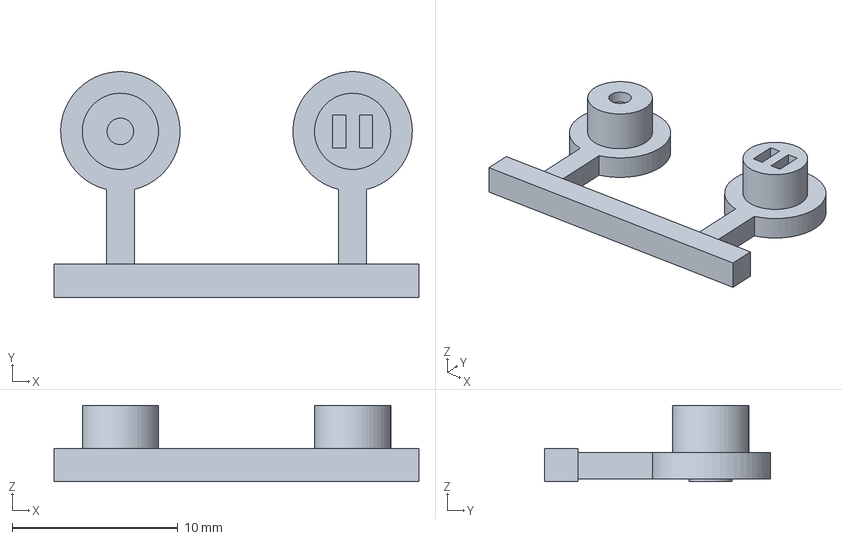
[picture p57: CAD file, 2026-10-19]
enclosure/r03/step_optional/x1_buttons_on_sprue_CUT_AFTER_PRINT.step
22.0 x 13.6 x 4.60 mm
