wyatt-liao/yuhuan-x1/enclosure/r03/stl/x1_battery_slot_gauge.stl

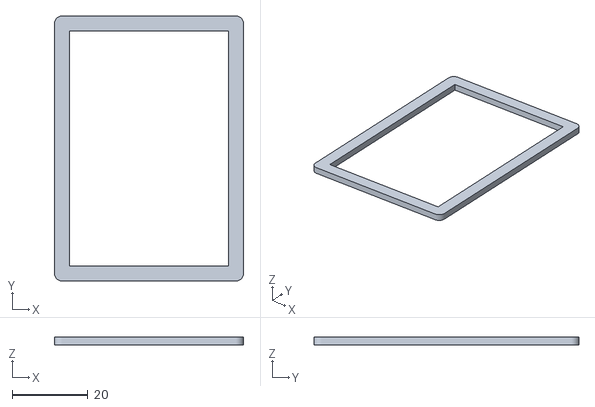
[picture p58: CAD file, 2026-10-19]
enclosure/r03/stl/x1_battery_slot_gauge.stl
49.9 x 70.0 x 2.00
