wyatt-liao/yuhuan-x1/enclosure/r01/step/x1_lid.step

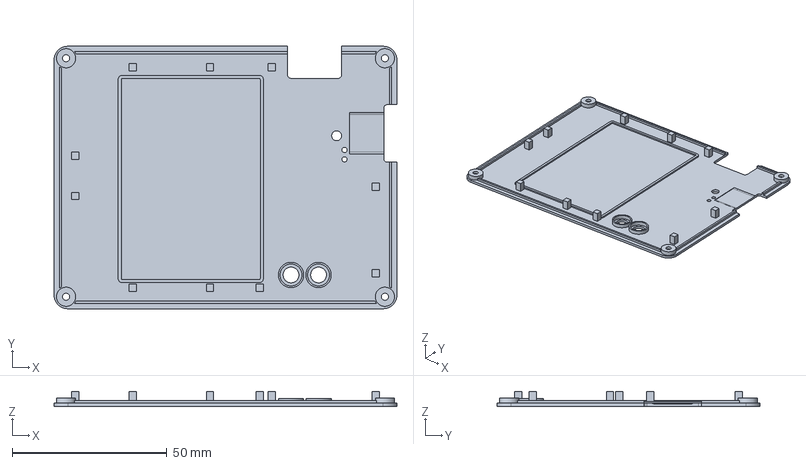
[picture p61: CAD file, 2026-10-19]
enclosure/r01/step/x1_lid.step
110.8 x 84.8 x 4.70 mm
