wyatt-liao/yuhuan-x1/enclosure/r03/step/x1_joint_plastic_coupon.step

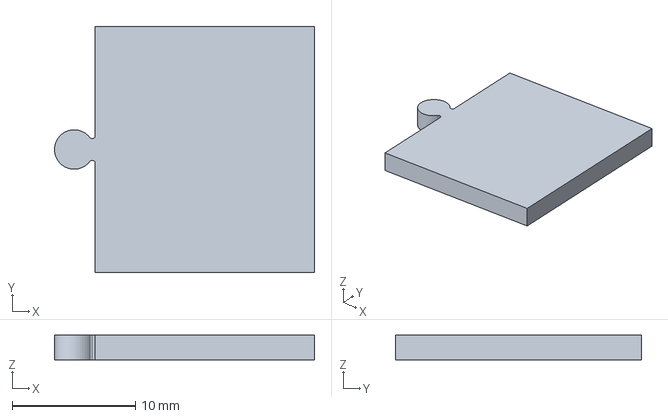
[picture p62: CAD file, 2026-10-19]
enclosure/r03/step/x1_joint_plastic_coupon.step
21.1 x 20.0 x 2.00 mm
