wyatt-liao/yuhuan-x1/enclosure/r01/step/x1_base.step

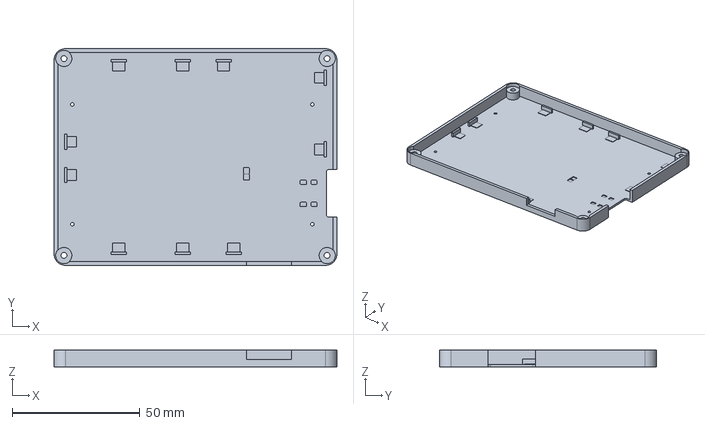
[picture p63: CAD file, 2026-10-19]
enclosure/r01/step/x1_base.step
110.8 x 84.8 x 6.60 mm
