wyatt-liao/yuhuan-x1/enclosure/r02/step/x1_joint_metal_coupon.step

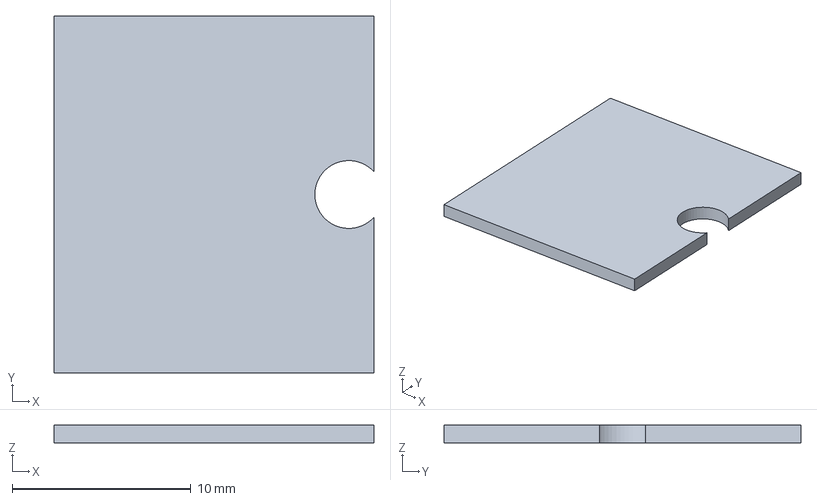
[picture p64: CAD file, 2026-10-19]
enclosure/r02/step/x1_joint_metal_coupon.step
17.9 x 20.0 x 1.00 mm
