wyatt-liao/yuhuan-x1/enclosure/r03/step/x1_lid_metal.step

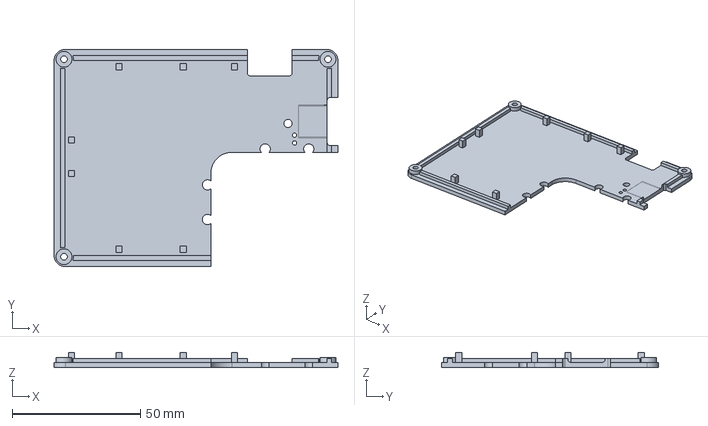
[picture p65: CAD file, 2026-10-19]
enclosure/r03/step/x1_lid_metal.step
110.8 x 84.8 x 5.85 mm
