wyatt-liao/yuhuan-x1/enclosure/r03/step/x1_base_metal.step

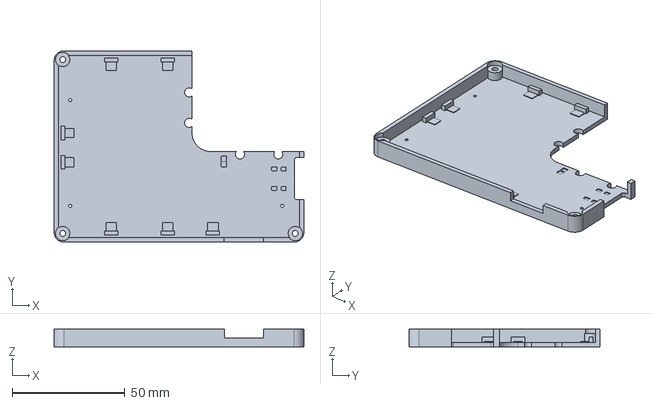
[picture p66: CAD file, 2026-10-19]
enclosure/r03/step/x1_base_metal.step
110.8 x 84.8 x 7.80 mm
