wyatt-liao/yuhuan-x1/enclosure/r02/step/x1_joint_plastic_coupon.step

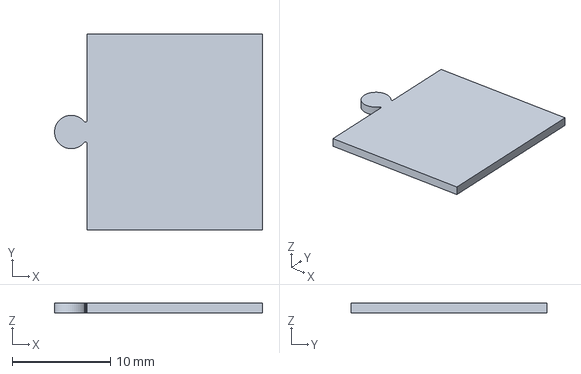
[picture p67: CAD file, 2026-10-19]
enclosure/r02/step/x1_joint_plastic_coupon.step
21.2 x 20.0 x 1.00 mm
