wyatt-liao/yuhuan-x1/enclosure/r03/step/x1_joint_metal_coupon.step

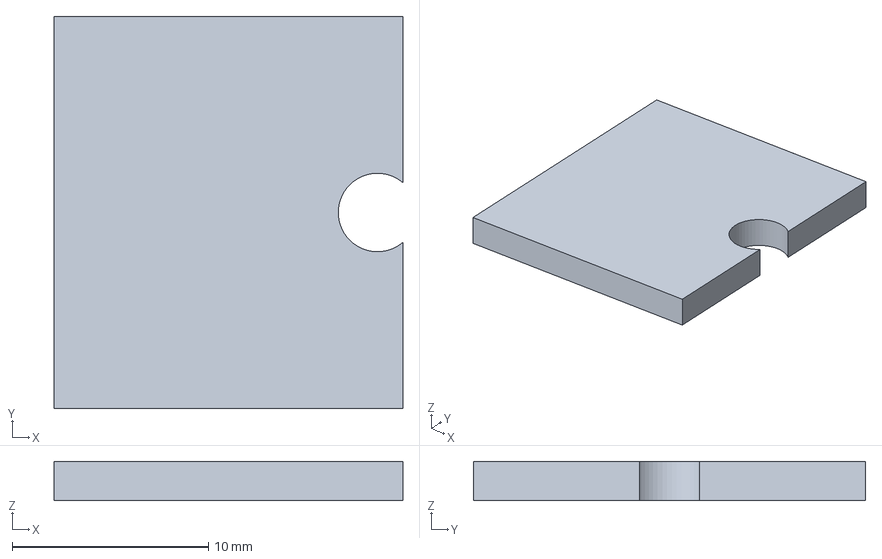
[picture p68: CAD file, 2026-10-19]
enclosure/r03/step/x1_joint_metal_coupon.step
17.8 x 20.0 x 2.00 mm
