wyatt-liao/yuhuan-x1/enclosure/r02/step/x1_base_metal.step

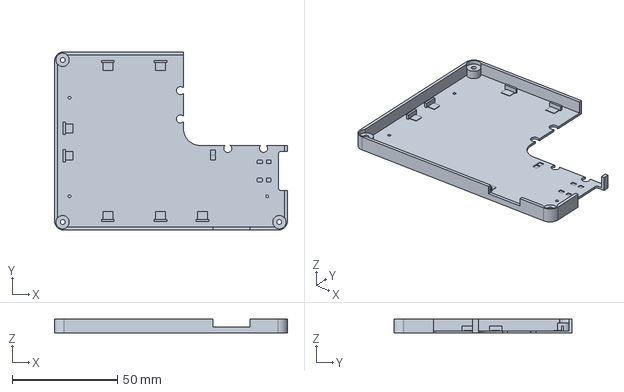
[picture p70: CAD file, 2026-10-19]
enclosure/r02/step/x1_base_metal.step
110.8 x 84.8 x 6.60 mm
