wyatt-liao/yuhuan-x1/enclosure/r03/step/x1_button_recall.step

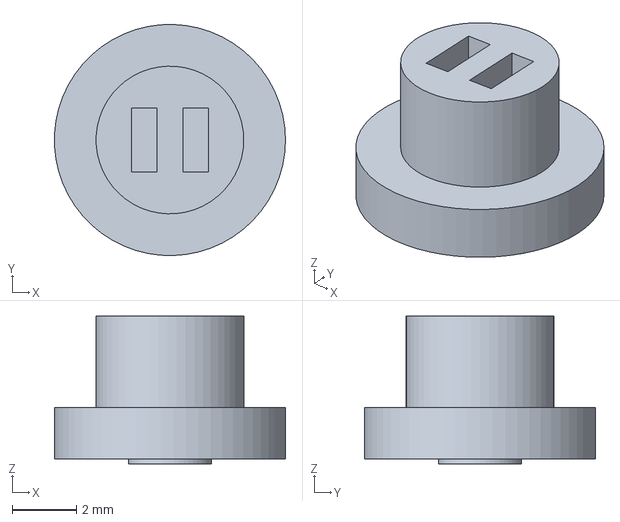
[picture p71: CAD file, 2026-10-19]
enclosure/r03/step/x1_button_recall.step
7.19 x 7.20 x 4.60 mm
