wyatt-liao/yuhuan-x1/enclosure/r02/step/x1_base_rf_plastic.step

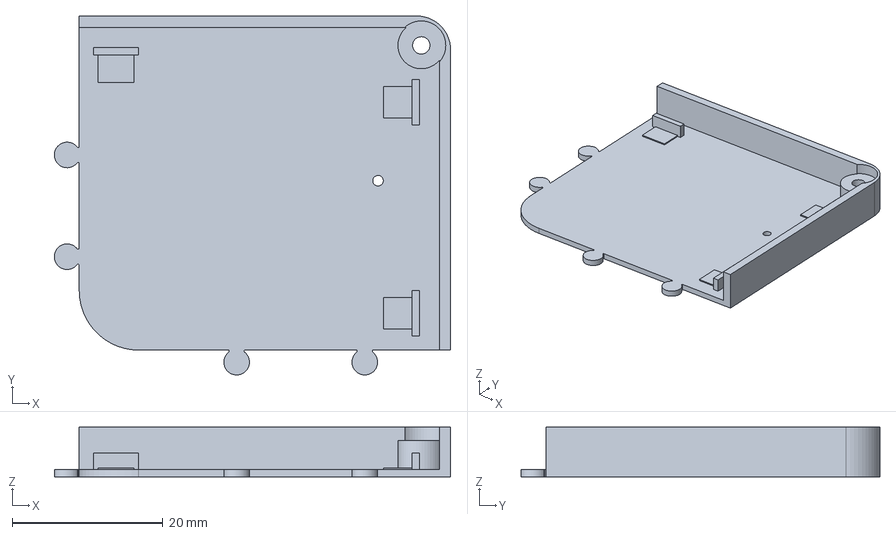
[picture p72: CAD file, 2026-10-19]
enclosure/r02/step/x1_base_rf_plastic.step
52.6 x 47.6 x 6.60 mm
