wyatt-liao/yuhuan-x1/enclosure/r03/step/x1_base_rf_plastic.step

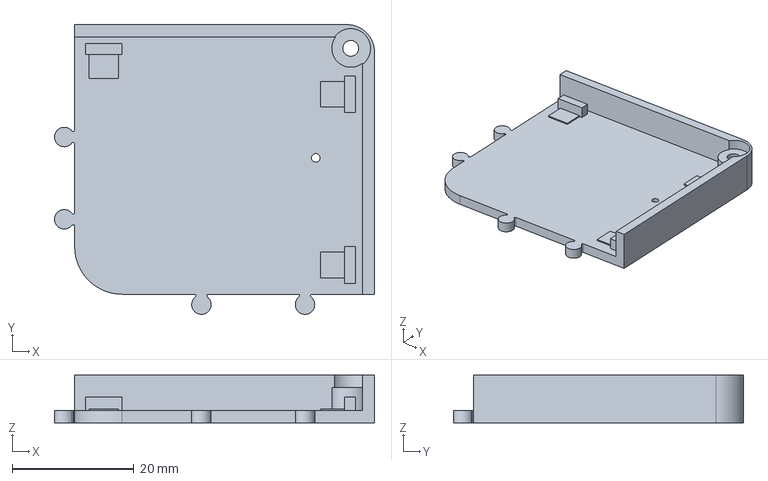
[picture p73: CAD file, 2026-10-19]
enclosure/r03/step/x1_base_rf_plastic.step
52.5 x 47.5 x 7.80 mm
