wyatt-liao/yuhuan-x1/(list of files, cad)

Other CAD files:
enclosure/r01/step/x1_assembly_reference.step
enclosure/r02/reference/pcb_with_cutout.step
enclosure/r03/reference/pcb_with_cutout.step
enclosure/r01/step/x1_button_recall.step
enclosure/r02/step/x1_button_recall.step
enclosure/r02/step/x1_button_record.step
enclosure/r01/stl/x1_base.stl
enclosure/r01/stl/x1_button_recall.stl
enclosure/r01/stl/x1_button_record.stl
enclosure/r01/stl/x1_lid.stl
enclosure/r02/stl/x1_base_metal.stl
enclosure/r02/stl/x1_base_rf_plastic.stl
enclosure/r02/stl/x1_button_recall.stl
enclosure/r02/stl/x1_button_record.stl
enclosure/r02/stl/x1_joint_metal_coupon.stl
enclosure/r02/stl/x1_joint_plastic_coupon.stl
enclosure/r02/stl/x1_lid_metal.stl
enclosure/r02/stl/x1_lid_rf_plastic.stl
enclosure/r03/stl/x1_base_metal.stl
enclosure/r03/stl/x1_base_rf_plastic.stl
enclosure/r03/stl/x1_button_recall.stl
enclosure/r03/stl/x1_button_record.stl
enclosure/r03/stl/x1_joint_metal_coupon.stl
enclosure/r03/stl/x1_joint_plastic_coupon.stl
enclosure/r03/stl/x1_lid_metal.stl
enclosure/r03/stl/x1_lid_rf_plastic.stl
enclosure/r03/stl_optional/x1_buttons_on_sprue_CUT_AFTER_PRINT.stl
media/film/assets/Voloop-X1-CG.blend
media/film/assets/Yuhuan-X1-R03-CG.blend
