wyatt-liao/yuhuan-x1/android/release/reports/lint-results-debug.txt

/Users/wyatt/Documents/Codex/2026-10-18/easyeda-edaagent-15/outputs/yuhuan-x1-android/app/src/main/AndroidManifest.xml:10: Warning: Attribute usesPermissionFlags is only used in API level 31 and higher (current min is 26) [UnusedAttribute]
    <uses-permission android:name="android.permission.BLUETOOTH_SCAN" android:usesPermissionFlags="neverForLocation" />
                                                                      ~~~~~~~~~~~~~~~~~~~~~~~~~~~~~~~~~~~~~~~~~~~~~~

   Explanation for issues of type "UnusedAttribute":
   This check finds attributes set in XML files that were introduced in a
   version newer than the oldest version targeted by your application (with
   the minSdkVersion attribute).

   This is not an error; the application will simply ignore the attribute.
   However, if the attribute is important to the appearance or functionality
   of your application, you should consider finding an alternative way to
   achieve the same result with only available attributes, and then you can
   optionally create a copy of the layout in a layout-vNN folder which will be
   used on API NN or higher where you can take advantage of the newer
   attribute.

   Note: This check does not only apply to attributes. For example, some tags
   can be unused too, such as the new <tag> element in layouts introduced in
   API 21.

/Users/wyatt/Documents/Codex/2026-10-18/easyeda-edaagent-15/outputs/yuhuan-x1-android/gradle/wrapper/gradle-wrapper.properties:3: Warning: A newer version of Gradle than 8.13 is available: 8.14.6 [AndroidGradlePluginVersion]
distributionUrl=https\://services.gradle.org/distributions/gradle-8.13-bin.zip
                ~~~~~~~~~~~~~~~~~~~~~~~~~~~~~~~~~~~~~~~~~~~~~~~~~~~~~~~~~~~~~~

   Explanation for issues of type "AndroidGradlePluginVersion":
   This detector looks for usage of the Android Gradle Plugin where the
   version you are using is not the current stable release. Using older
   versions is fine, and there are cases where you deliberately want to stick
   with an older version. However, you may simply not be aware that a more
   recent version is available, and that is what this lint check helps find.

/Users/wyatt/Documents/Codex/2026-10-18/easyeda-edaagent-15/outputs/yuhuan-x1-android/app/build.gradle.kts:28: Warning: A newer version of androidx.compose:compose-bom than 2025.06.01 is available: 2026.09.00 [GradleDependency]
    implementation(platform("androidx.compose:compose-bom:2025.06.01"))
                   ~~~~~~~~~~~~~~~~~~~~~~~~~~~~~~~~~~~~~~~~~~~~~~~~~~~
/Users/wyatt/Documents/Codex/2026-10-18/easyeda-edaagent-15/outputs/yuhuan-x1-android/app/build.gradle.kts:29: Warning: A newer version of androidx.activity:activity-compose than 1.10.1 is available: 1.13.0 [GradleDependency]
    implementation("androidx.activity:activity-compose:1.10.1")
                   ~~~~~~~~~~~~~~~~~~~~~~~~~~~~~~~~~~~~~~~~~~~
/Users/wyatt/Documents/Codex/2026-10-18/easyeda-edaagent-15/outputs/yuhuan-x1-android/app/build.gradle.kts:30: Warning: A newer version of androidx.lifecycle:lifecycle-runtime-compose than 2.9.1 is available: 2.11.0 [GradleDependency]
    implementation("androidx.lifecycle:lifecycle-runtime-compose:2.9.1")
                   ~~~~~~~~~~~~~~~~~~~~~~~~~~~~~~~~~~~~~~~~~~~~~~~~~~~~
/Users/wyatt/Documents/Codex/2026-10-18/easyeda-edaagent-15/outputs/yuhuan-x1-android/app/build.gradle.kts:31: Warning: A newer version of androidx.lifecycle:lifecycle-viewmodel-compose than 2.9.1 is available: 2.11.0 [GradleDependency]
    implementation("androidx.lifecycle:lifecycle-viewmodel-compose:2.9.1")
                   ~~~~~~~~~~~~~~~~~~~~~~~~~~~~~~~~~~~~~~~~~~~~~~~~~~~~~~
/Users/wyatt/Documents/Codex/2026-10-18/easyeda-edaagent-15/outputs/yuhuan-x1-android/app/build.gradle.kts:32: Warning: A newer version of androidx.core:core-ktx than 1.16.0 is available: 1.19.1 [GradleDependency]
    implementation("androidx.core:core-ktx:1.16.0")
                   ~~~~~~~~~~~~~~~~~~~~~~~~~~~~~~~
/Users/wyatt/Documents/Codex/2026-10-18/easyeda-edaagent-15/outputs/yuhuan-x1-android/app/build.gradle.kts:42: Warning: A newer version of androidx.compose:compose-bom than 2025.06.01 is available: 2026.09.00 [GradleDependency]
    androidTestImplementation(platform("androidx.compose:compose-bom:2025.06.01"))
                              ~~~~~~~~~~~~~~~~~~~~~~~~~~~~~~~~~~~~~~~~~~~~~~~~~~~
/Users/wyatt/Documents/Codex/2026-10-18/easyeda-edaagent-15/outputs/yuhuan-x1-android/app/build.gradle.kts:44: Warning: A newer version of androidx.test:runner than 1.6.2 is available: 1.7.0 [GradleDependency]
    androidTestImplementation("androidx.test:runner:1.6.2")
                              ~~~~~~~~~~~~~~~~~~~~~~~~~~~~
/Users/wyatt/Documents/Codex/2026-10-18/easyeda-edaagent-15/outputs/yuhuan-x1-android/app/build.gradle.kts:45: Warning: A newer version of androidx.test:rules than 1.6.1 is available: 1.7.0 [GradleDependency]
    androidTestImplementation("androidx.test:rules:1.6.1")
                              ~~~~~~~~~~~~~~~~~~~~~~~~~~~
/Users/wyatt/Documents/Codex/2026-10-18/easyeda-edaagent-15/outputs/yuhuan-x1-android/app/build.gradle.kts:46: Warning: A newer version of androidx.test.ext:junit than 1.2.1 is available: 1.3.0 [GradleDependency]
    androidTestImplementation("androidx.test.ext:junit:1.2.1")
                              ~~~~~~~~~~~~~~~~~~~~~~~~~~~~~~~

   Explanation for issues of type "GradleDependency":
   This detector looks for usages of libraries where the version you are using
   is not the current stable release. Using older versions is fine, and there
   are cases where you deliberately want to stick with an older version.
   However, you may simply not be aware that a more recent version is
   available, and that is what this lint check helps find.

/Users/wyatt/Documents/Codex/2026-10-18/easyeda-edaagent-15/outputs/yuhuan-x1-android/app/build.gradle.kts:36: Warning: A newer version of org.jetbrains.kotlinx:kotlinx-coroutines-android than 1.10.2 is available: 1.11.0 [NewerVersionAvailable]
    implementation("org.jetbrains.kotlinx:kotlinx-coroutines-android:1.10.2")
                   ~~~~~~~~~~~~~~~~~~~~~~~~~~~~~~~~~~~~~~~~~~~~~~~~~~~~~~~~~
/Users/wyatt/Documents/Codex/2026-10-18/easyeda-edaagent-15/outputs/yuhuan-x1-android/app/build.gradle.kts:40: Warning: A newer version of org.json:json than 20250107 is available: 20260814 [NewerVersionAvailable]
    testImplementation("org.json:json:20250107")
                       ~~~~~~~~~~~~~~~~~~~~~~~~
/Users/wyatt/Documents/Codex/2026-10-18/easyeda-edaagent-15/outputs/yuhuan-x1-android/app/build.gradle.kts:41: Warning: A newer version of org.jetbrains.kotlinx:kotlinx-coroutines-test than 1.10.2 is available: 1.11.0 [NewerVersionAvailable]
    testImplementation("org.jetbrains.kotlinx:kotlinx-coroutines-test:1.10.2")
                       ~~~~~~~~~~~~~~~~~~~~~~~~~~~~~~~~~~~~~~~~~~~~~~~~~~~~~~

   Explanation for issues of type "NewerVersionAvailable":
   This detector checks with a central repository to see if there are newer
   versions available for the dependencies used by this project. This is
   similar to the GradleDependency check, which checks for newer versions
   available in the Android SDK tools and libraries, but this works with any
   MavenCentral dependency, and connects to the library every time, which
   makes it more flexible but also much slower.

/Users/wyatt/Documents/Codex/2026-10-18/easyeda-edaagent-15/outputs/yuhuan-x1-android/app/src/main/java/com/yuhuan/x1/ui/X1App.kt:140: Warning: Using Configuration.screenHeightDp instead of LocalWindowInfo.current.containerSize [ConfigurationScreenWidthHeight from androidx.compose.ui]
    val sheetHeight=LocalConfiguration.current.screenHeightDp.dp*0.85f
                    ~~~~~~~~~~~~~~~~~~~~~~~~~~~~~~~~~~~~~~~~~

   Explanation for issues of type "ConfigurationScreenWidthHeight":
   Configuration.screenWidthDp and Configuration.screenHeightDp have different
   insets behaviour depending on target SDK version, and are rounded to the
   nearest Dp. This means that using these values in composition to size a
   layout can result in issues, as these values do not accurately represent
   the actual available window size. Instead it is recommended to use
   WindowInfo.containerSize which accurately represents the window size.

   Vendor: Jetpack Compose
   Identifier: androidx.compose.ui
   Feedback: https://issuetracker.google.com/issues/new?component=612128

/Users/wyatt/Documents/Codex/2026-10-18/easyeda-edaagent-15/outputs/yuhuan-x1-android/app/src/main/java/com/yuhuan/x1/ui/Components.kt:58: Warning: Modifier parameter should be the first optional parameter [ModifierParameter from androidx.compose.ui]
@Composable fun Waveform(peaks: List<Float>,progress: Float=0f,modifier: Modifier=Modifier) {
                                                               ~~~~~~~~

   Explanation for issues of type "ModifierParameter":
   The first (or only) Modifier parameter in a Composable function should
   follow the following rules:
   - Be named modifier
   - Have a type of Modifier
   - Either have no default value, or have a default value of Modifier
   - If optional, be the first optional parameter in the parameter list

   Vendor: Jetpack Compose
   Identifier: androidx.compose.ui
   Feedback: https://issuetracker.google.com/issues/new?component=612128

/Users/wyatt/Documents/Codex/2026-10-18/easyeda-edaagent-15/outputs/yuhuan-x1-android/app/src/main/res/xml/network_security_config.xml:3: Warning: Insecure Base Configuration [InsecureBaseConfiguration]
<network-security-config><base-config cleartextTrafficPermitted="true" /></network-security-config>
                                                                 ~~~~

   Explanation for issues of type "InsecureBaseConfiguration":
   Permitting cleartext traffic could allow eavesdroppers to intercept data
   sent by your app, which impacts the privacy of your users. Consider only
   allowing encrypted traffic by setting the cleartextTrafficPermitted tag to
   false.

   https://goo.gle/InsecureBaseConfiguration
   https://developer.android.com/preview/features/security-config.html

/Users/wyatt/Documents/Codex/2026-10-18/easyeda-edaagent-15/outputs/yuhuan-x1-android/app/src/main/AndroidManifest.xml:16: Warning: The attribute android:dataExtractionRules only applies for Android 12 and higher; since minSdkVersion is API 26 you should also set android:fullBackupContent [DataExtractionRules]
        android:icon="@drawable/ic_launcher" android:allowBackup="false" android:dataExtractionRules="@xml/data_extraction_rules" android:supportsRtl="true"
                                                                                                      ~~~~~~~~~~~~~~~~~~~~~~~~~~

   Explanation for issues of type "DataExtractionRules":
   Before Android 12, the attributes android:allowBackup and
   android:fullBackupContent were used to configure all forms of backup,
   including cloud backups, device-to-device transfers and adb backup.

   In Android 12 and higher, these attributes have been deprecated and will
   only apply to cloud backups. You should instead use the attribute
   android:dataExtractionRules, specifying an @xml resource that configures
   which files to back up, for cloud backups and for device-to-device
   transfers, separately. If your minSdkVersion supports older versions,
   you'll still want to specify an android:fullBackupContent resource if the
   default behavior is not right for your app.

   https://developer.android.com/about/versions/12/backup-restore#xml-changes
   https://goo.gle/DataExtractionRules

/Users/wyatt/Documents/Codex/2026-10-18/easyeda-edaagent-15/outputs/yuhuan-x1-android/app/src/main/java/com/yuhuan/x1/sync/RecorderRepository.kt:115: Warning: Consider also using StorageManager#getAllocatableBytes and allocateBytes which will consider clearable cached data [UsableSpace]
                        if(wasMissing)check(context.filesDir.usableSpace>s.bytes+32L*1024*1024) { "手机空间不足，请清理后继续" }
                                                             ~~~~~~~~~~~
/Users/wyatt/Documents/Codex/2026-10-18/easyeda-edaagent-15/outputs/yuhuan-x1-android/app/src/main/java/com/yuhuan/x1/ui/X1App.kt:116: Warning: Consider also using StorageManager#getAllocatableBytes and allocateBytes which will consider clearable cached data [UsableSpace]
                                    check(dir.usableSpace>c.samples*2+64L*1024*1024) { "手机空间不足，无法导出 PCM 音频" }
                                              ~~~~~~~~~~~

   Explanation for issues of type "UsableSpace":
   When you need to allocate disk space for large files, consider using the
   new allocateBytes(FileDescriptor, long) API, which will automatically clear
   cached files belonging to other apps (as needed) to meet your request.

   When deciding if the device has enough disk space to hold your new data,
   call getAllocatableBytes(UUID) instead of using getUsableSpace(), since the
   former will consider any cached data that the system is willing to clear on
   your behalf.

   Note that these methods require API level 26. If your app is running on
   older devices, you will probably need to use both APIs, conditionally
   switching on Build.VERSION.SDK_INT. Lint only looks in the same compilation
   unit to see if you are already using both APIs, so if it warns even though
   you are already using the new API, consider moving the calls to the same
   file or suppressing the warning.

/Users/wyatt/Documents/Codex/2026-10-18/easyeda-edaagent-15/outputs/yuhuan-x1-android/app/src/main/java/com/yuhuan/x1/data/Secrets.kt:19: Warning: Use the KTX extension function SharedPreferences.edit instead? [UseKtx]
        set(value) { prefs.edit().putString("address",value).apply() }
                     ~~~~~~~~~~~~
/Users/wyatt/Documents/Codex/2026-10-18/easyeda-edaagent-15/outputs/yuhuan-x1-android/app/src/main/java/com/yuhuan/x1/data/Secrets.kt:22: Warning: Use the KTX extension function SharedPreferences.edit instead? [UseKtx]
        set(value) { prefs.edit().putBoolean("auto",value).apply() }
                     ~~~~~~~~~~~~
/Users/wyatt/Documents/Codex/2026-10-18/easyeda-edaagent-15/outputs/yuhuan-x1-android/app/src/main/java/com/yuhuan/x1/data/Secrets.kt:34: Warning: Use the KTX extension function SharedPreferences.edit instead? [UseKtx]
        prefs.edit().putString("token:$address",encoded).apply()
        ~~~~~~~~~~~~
/Users/wyatt/Documents/Codex/2026-10-18/easyeda-edaagent-15/outputs/yuhuan-x1-android/app/src/main/java/com/yuhuan/x1/data/Secrets.kt:41: Warning: Use the KTX extension function SharedPreferences.edit instead? [UseKtx]
    fun forget() { val old=address;prefs.edit().remove("token:$old").remove("address").putBoolean("auto",false).apply() }
                                   ~~~~~~~~~~~~

   Explanation for issues of type "UseKtx":
   The Android KTX libraries decorates the Android platform SDK as well as
   various libraries with more convenient extension functions available from
   Kotlin, allowing you to use default parameters, named parameters, and
   more.

   Available options:

   **remove-defaults** (default is true):
   Whether to skip arguments that match the defaults provided by the extension.

   Extensions often provide default values for some of the parameters. For example:
   ```kotlin
   fun Path.readLines(charset: Charset = Charsets.UTF_8): List<String> { return Files.readAllLines(this, charset) }
   ```
   This lint check will by default automatically omit parameters that match the default, so if your code was calling

   ```kotlin
   Files.readAllLines(file, Charset.UTF_8)
   ```
   lint would replace this with
   ```kotlin
   file.readLines()
   ```
   rather than

   ```kotlin
   file.readLines(Charset.UTF_8
   ```
   You can turn this behavior off using this option.

   To configure this option, use a `lint.xml` file with an <option> like this:

   ```xml
   <lint>
       <issue id="UseKtx">
           <option name="remove-defaults" value="true" />
       </issue>
   </lint>
   ```

   **require-present** (default is true):
   Whether to only offer extensions already available.

   This option lets you only have lint suggest extension replacements if those extensions are already available on the class path (in other words, you're already depending on the library containing the extension method.)

   To configure this option, use a `lint.xml` file with an <option> like this:

   ```xml
   <lint>
       <issue id="UseKtx">
           <option name="require-present" value="true" />
       </issue>
   </lint>
   ```

0 errors, 24 warnings
