wyatt-liao/yuhuan-x1/media/film/verification/encoded-contact.png

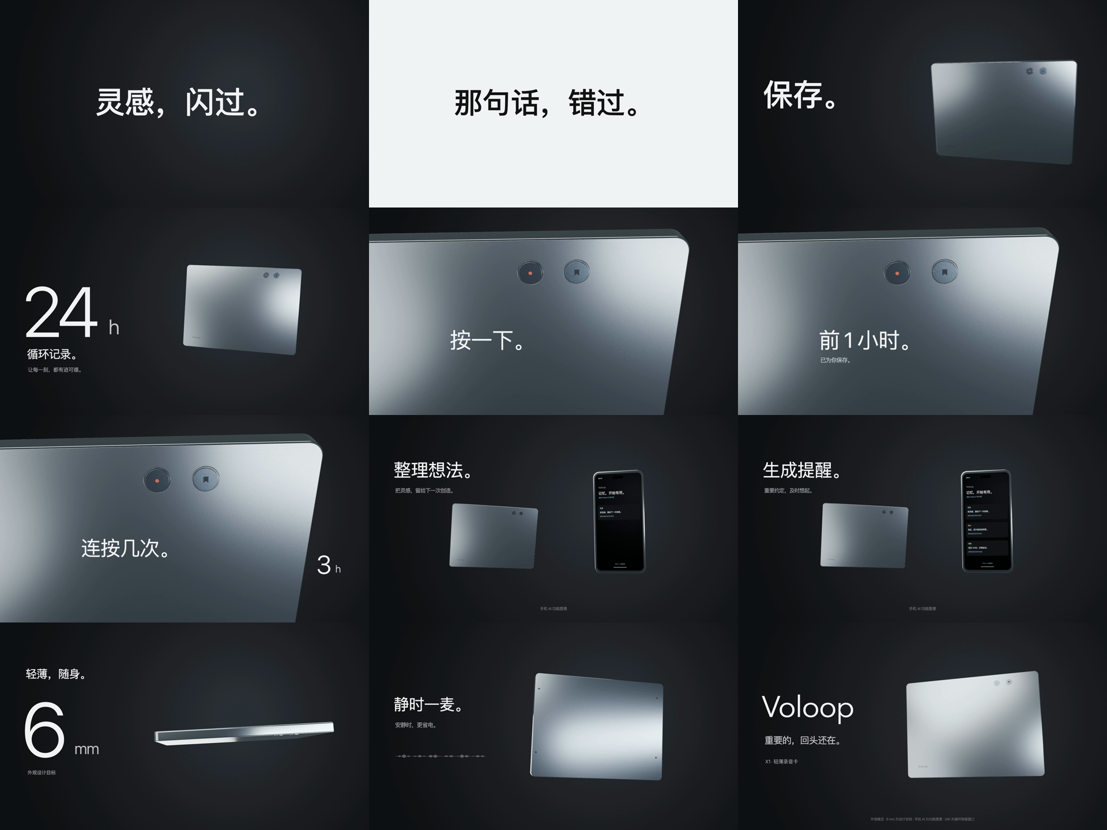
media/film/verification/encoded-contact.png
