wyatt-liao/yuhuan-x1/media/film/verification/transition-contact.jpg

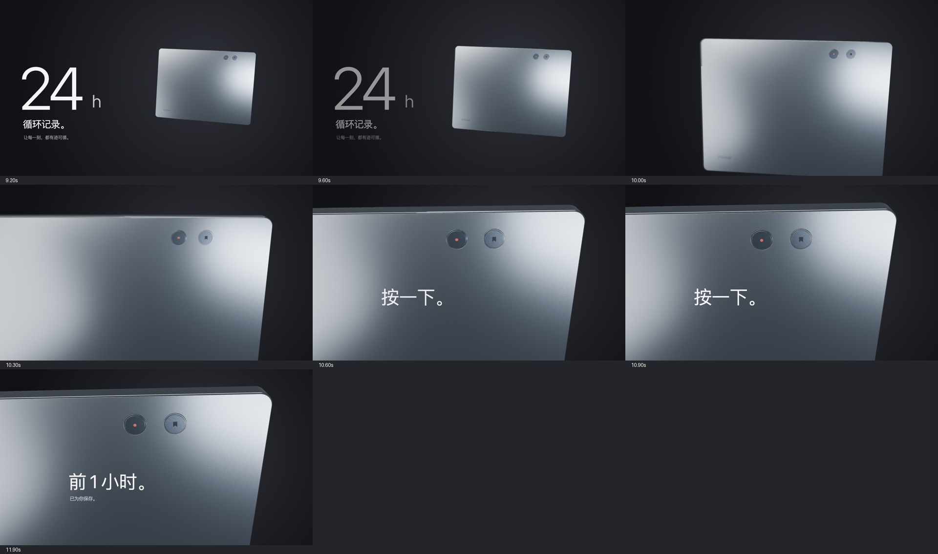
media/film/verification/transition-contact.jpg
