wyatt-liao/yuhuan-x1/(list of files, drawings)

Other design files:
enclosure/r01/source/pcb-live.json
enclosure/r02/reference/pcb-source-live-parsed.json
enclosure/r02/source/pcb-live.json
enclosure/r03/source/pcb-live.json
media/film/verification/pcb-alignment.json
media/film/verification/pcb-capture.json
