wyatt-liao/yuhuan-x1/(commit log)

2026-10-19 Import Yuhuan X1 hardware, firmware, Android app, media and SLA enclosure R03
    [Voloop-X1-CG.blend, partitions.csv, pcb-alignment.json, pcb-capture.json, pcb-live.json, pcb-source-live-parsed.json, pcb_with_cutout.step, x1_assembly_reference.step]
2026-10-19 Organize source modules and public project documentation
    [Voloop-X1-CG.blend, partitions.csv, pcb-alignment.json, pcb-capture.json, pcb-live.json, pcb-source-live-parsed.json, pcb_with_cutout.step, x1_assembly_reference.step]
2026-10-19 Finish unified R03 presentation and film deliverables
    [Yuhuan-X1-R03-CG.blend]
